meh2481/picopinball/code/displayController/images/score_display_vert.bmp

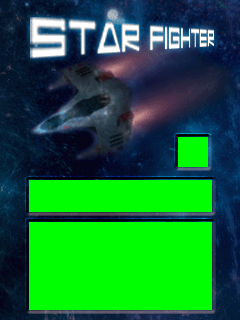
code/displayController/images/score_display_vert.bmp
