meh2481/picopinball/README.md

# picopinball
Physical Pi Pico-Powered Pinball table heavily inspired by Space Cadet
