meh2481/picopinball/FreeCad/popBumperAssembly.FCStd

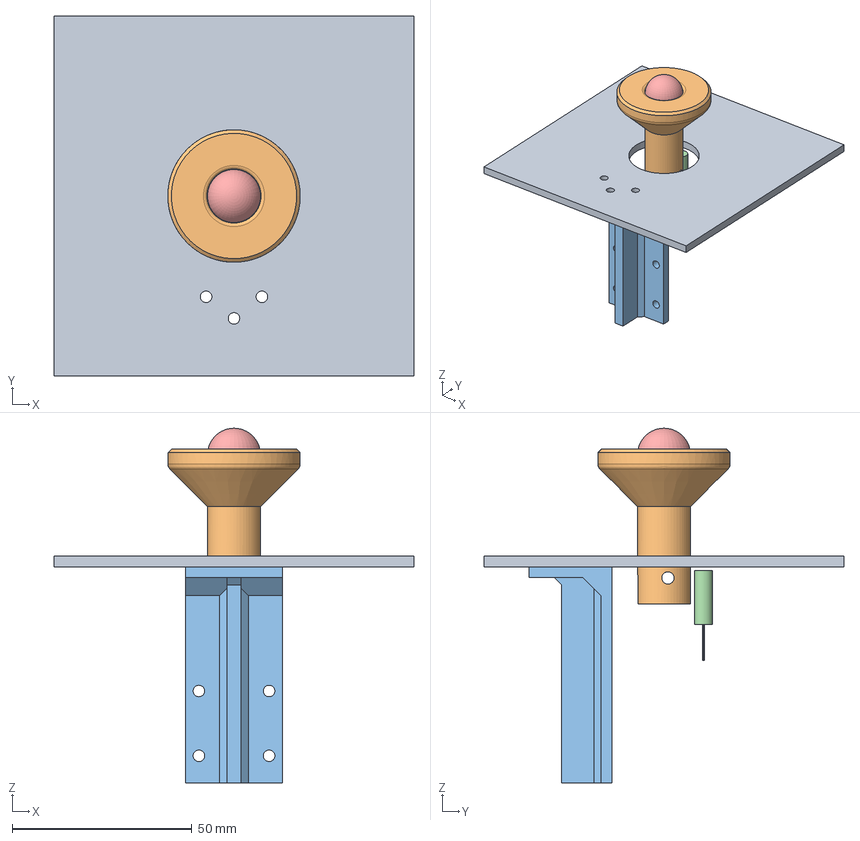
[picture p2: CAD file, 2022-09-14]
FreeCad/popBumperAssembly.FCStd
100.0 x 100.0 x 98.5 mm
board
bumperPlunger
popBumperSolenoidBracket
mockVibrationSensor
plungerCap
