meh2481/picopinball/FreeCad/measurements/slingshotCover.FCStd

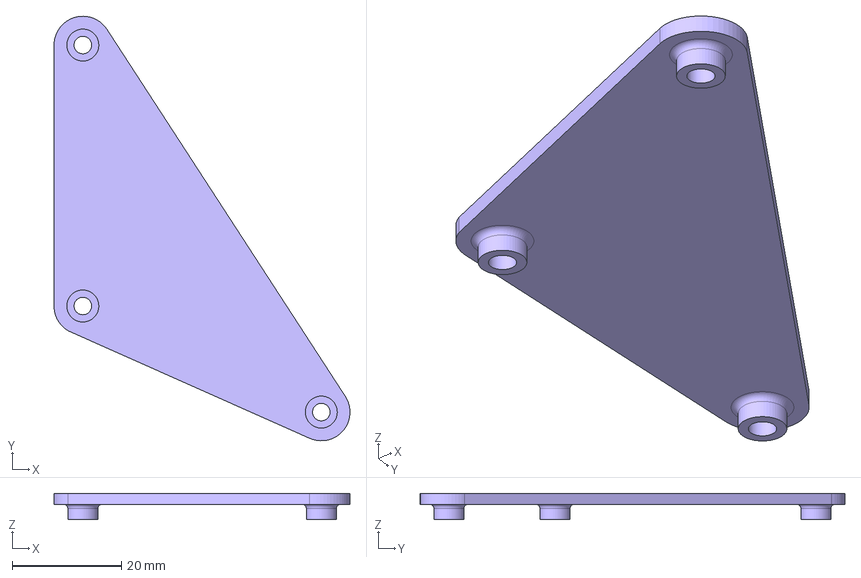
[picture p3: CAD file, 2022-11-23]
FreeCad/measurements/slingshotCover.FCStd
54.1 x 77.6 x 4.80 mm
