meh2481/picopinball/FreeCad/plungerGuide.FCStd

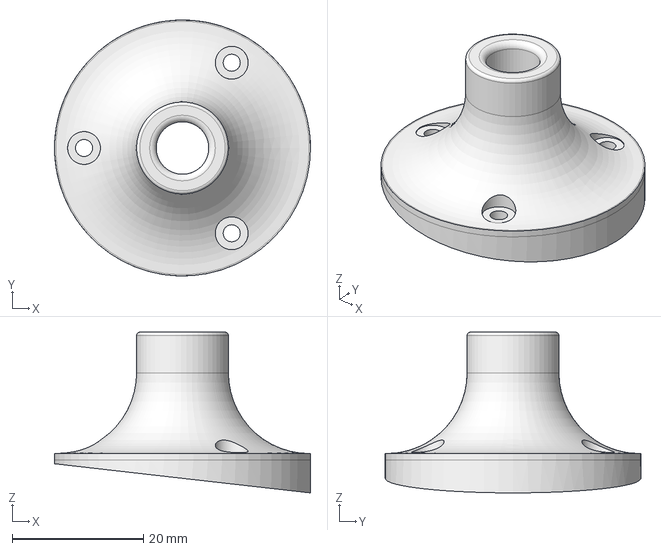
[picture p4: CAD file, 2022-12-01]
FreeCad/plungerGuide.FCStd
39.0 x 39.0 x 24.5 mm
