meh2481/picopinball/FreeCad/flipper2.FCStd

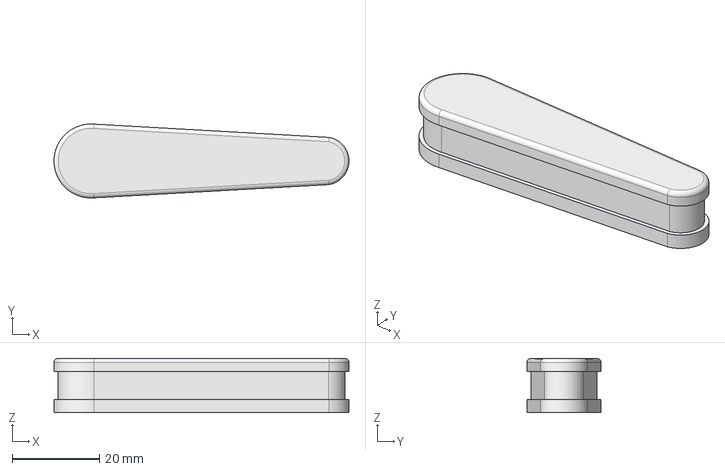
[picture p5: CAD file, 2022-11-29]
FreeCad/flipper2.FCStd
67.7 x 17.0 x 12.5 mm
