meh2481/picopinball/FreeCad/slingshot_switch4.FCStd

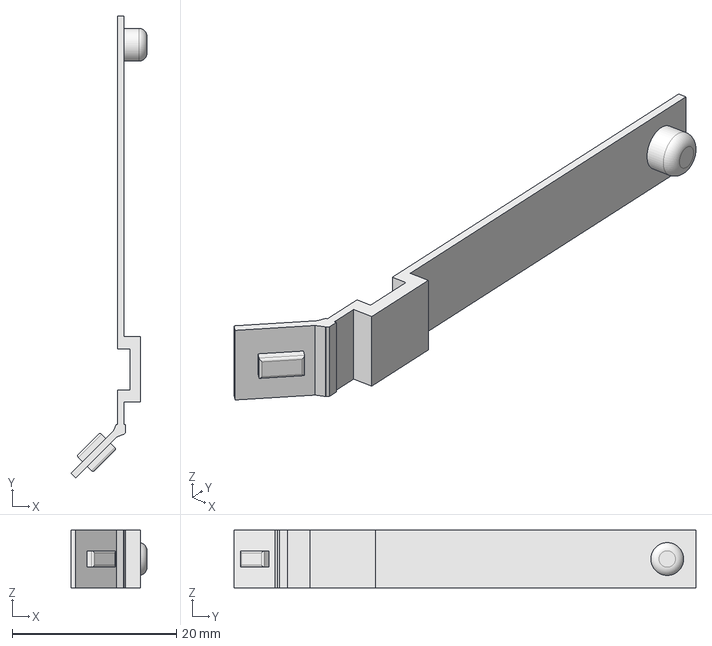
[picture p6: CAD file, 2022-11-26]
FreeCad/slingshot_switch4.FCStd
9.26 x 56.2 x 7.00 mm
