meh2481/picopinball/FreeCad/triangleLightHolder.FCStd

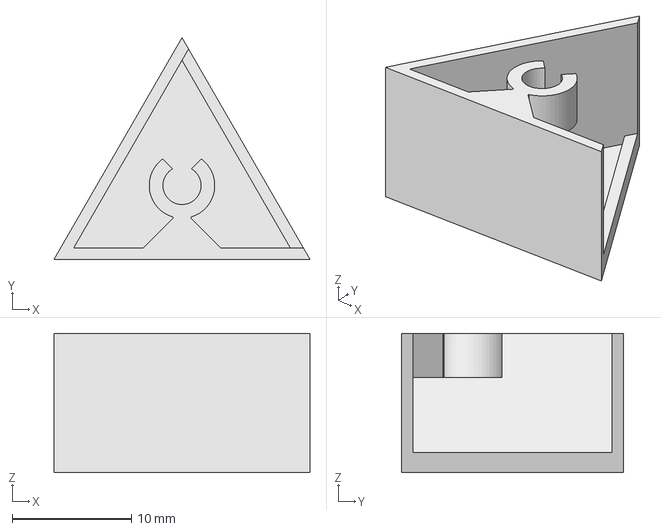
[picture p7: CAD file, 2022-11-23]
FreeCad/triangleLightHolder.FCStd
21.5 x 18.6 x 11.7 mm
