meh2481/picopinball/FreeCad/threeArrowsLightHolder.FCStd

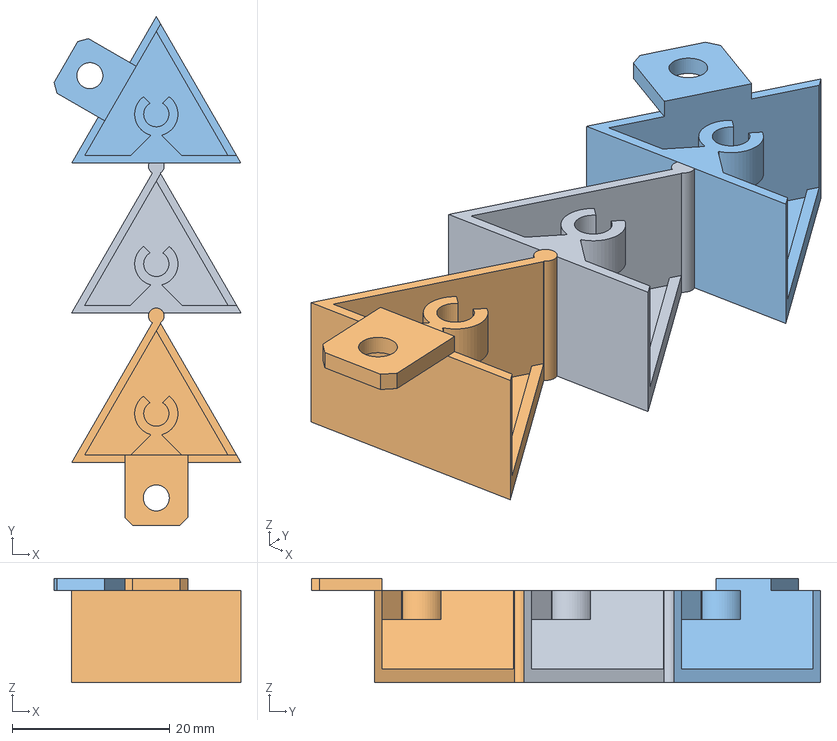
[picture p8: CAD file, 2022-11-23]
FreeCad/threeArrowsLightHolder.FCStd
23.7 x 64.6 x 13.2 mm
arrowMiddle
arrowBottom
arrowTop
