meh2481/picopinball/FreeCad/circleLightHolder.FCStd

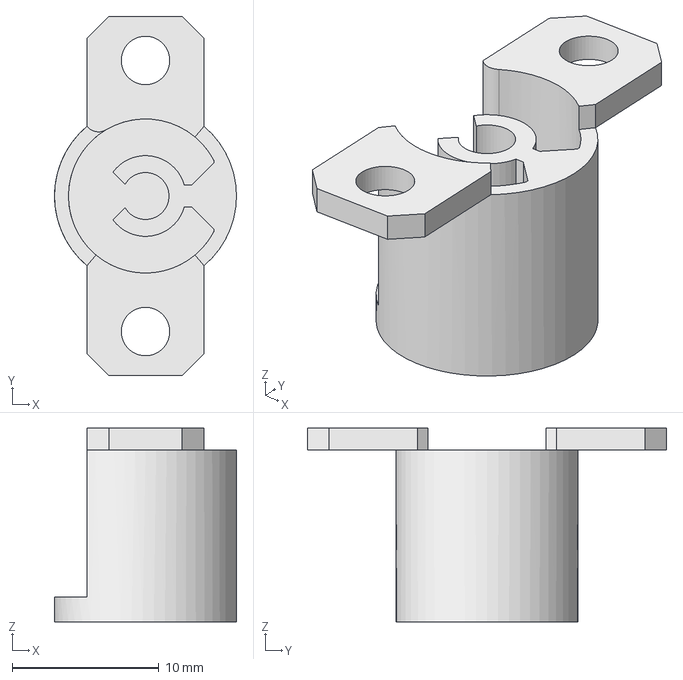
[picture p9: CAD file, 2022-11-23]
FreeCad/circleLightHolder.FCStd
12.4 x 24.5 x 13.2 mm
