meh2481/picopinball/FreeCad/hyperspaceBarLight-36.FCStd

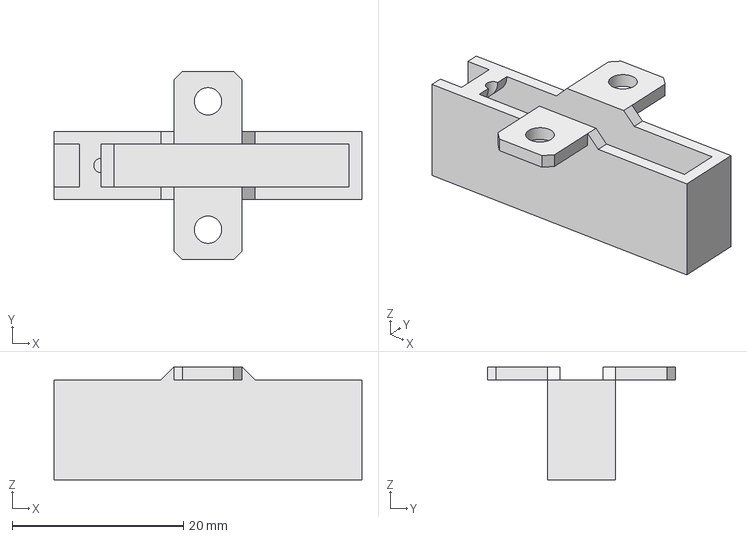
[picture p10: CAD file, 2022-11-23]
FreeCad/hyperspaceBarLight-36.FCStd
36.0 x 22.0 x 13.2 mm
