meh2481/picopinball/FreeCad/hyperspaceBarLight.FCStd

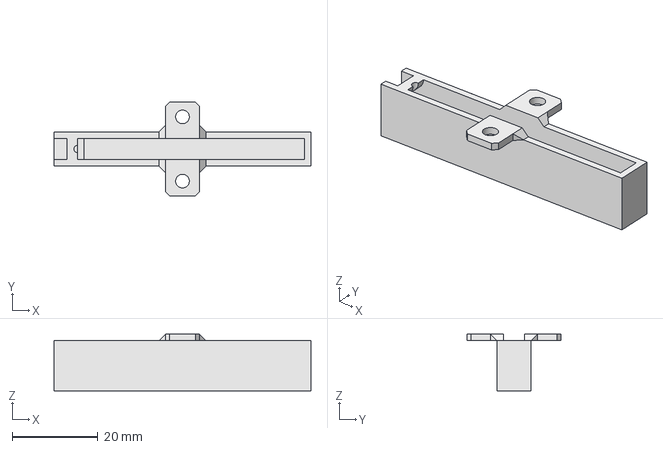
[picture p11: CAD file, 2022-11-23]
FreeCad/hyperspaceBarLight.FCStd
60.0 x 22.0 x 13.2 mm
