meh2481/picopinball/FreeCad/displayBracket.FCStd

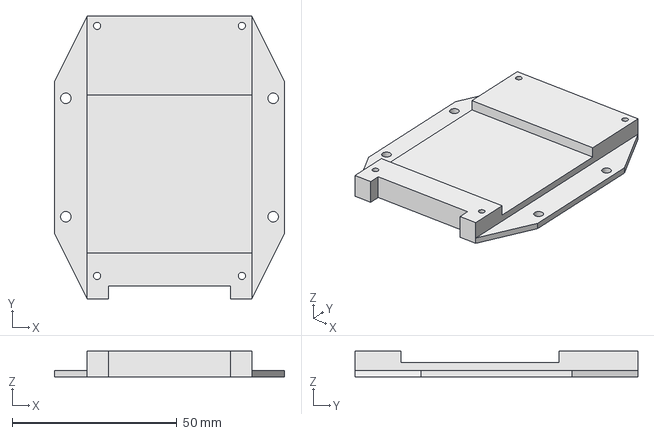
[picture p12: CAD file, 2022-11-17]
FreeCad/displayBracket.FCStd
70.0 x 86.0 x 7.80 mm
