meh2481/picopinball/FreeCad/ledRingHolder.FCStd

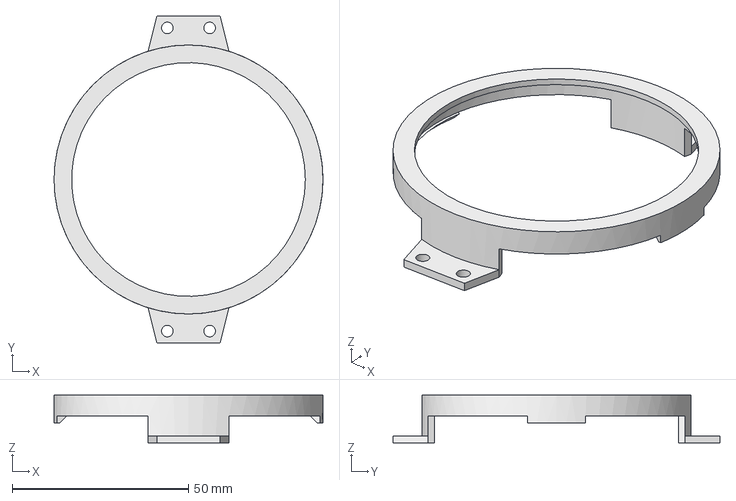
[picture p13: CAD file, 2022-11-17]
FreeCad/ledRingHolder.FCStd
76.3 x 92.8 x 13.6 mm
