meh2481/picopinball/FreeCad/cableClip_tiny.FCStd

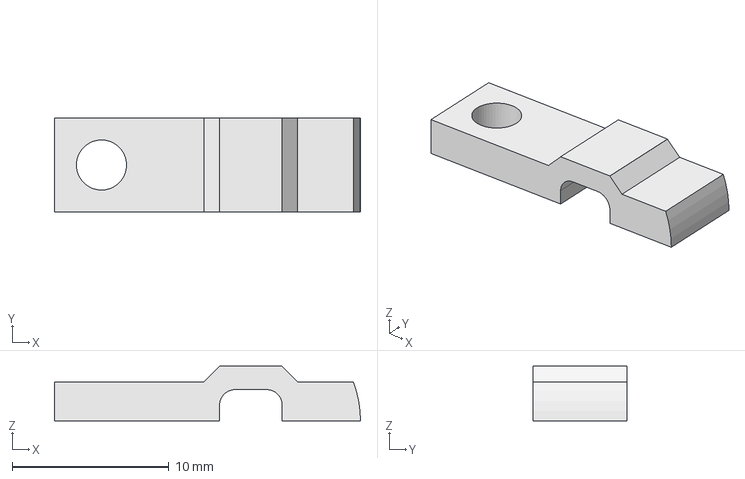
[picture p14: CAD file, 2022-11-09]
FreeCad/cableClip_tiny.FCStd
19.5 x 6.00 x 3.50 mm
