meh2481/picopinball/FreeCad/pegglePeg.FCStd

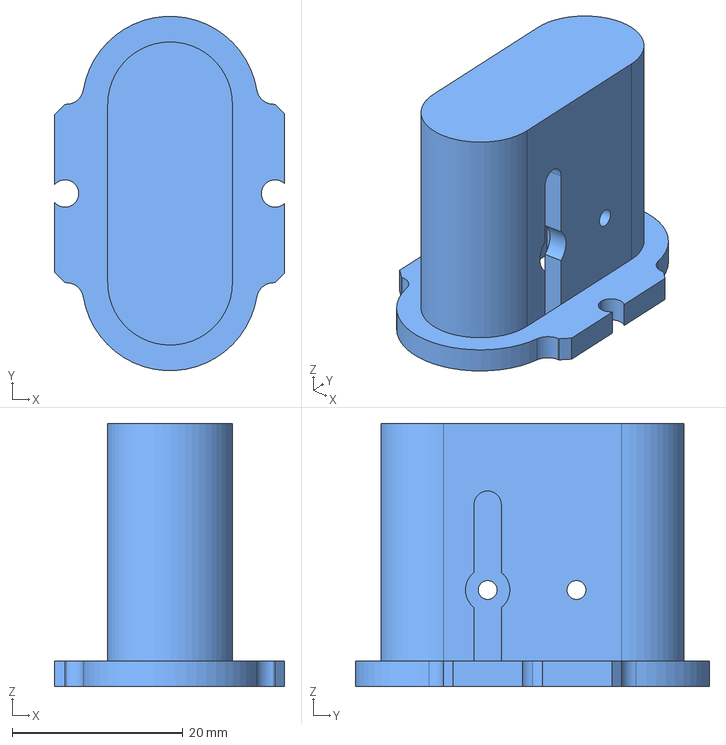
[picture p15: CAD file, 2022-10-25]
FreeCad/pegglePeg.FCStd
27.0 x 41.5 x 30.8 mm
