meh2481/picopinball/FreeCad/dowelSpringPlug.FCStd

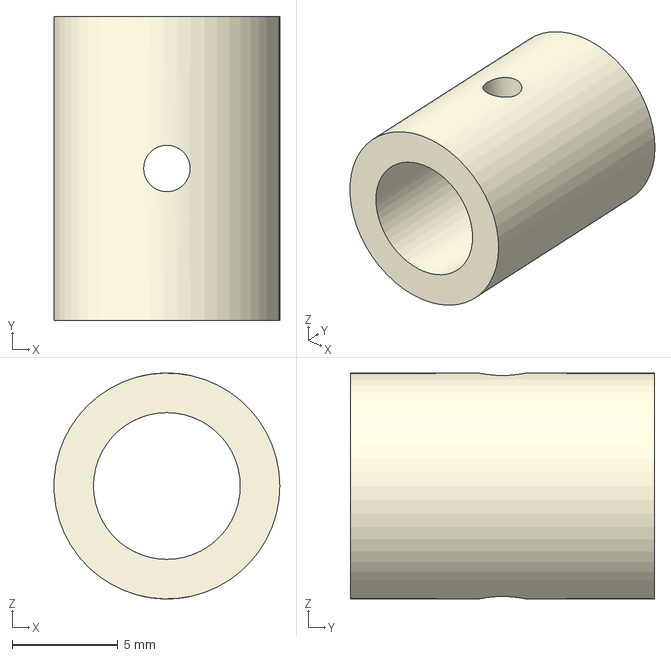
[picture p16: CAD file, 2022-10-25]
FreeCad/dowelSpringPlug.FCStd
10.7 x 14.4 x 10.7 mm
