meh2481/picopinball/FreeCad/slingshotCover.FCStd

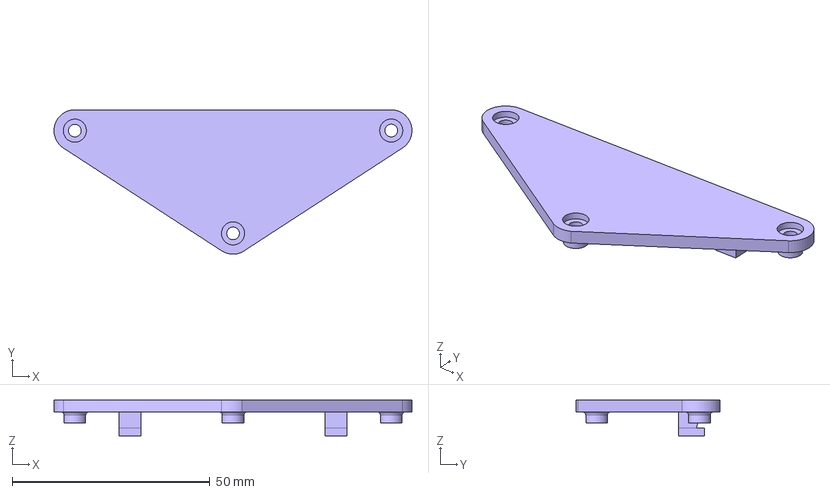
[picture p17: CAD file, 2022-10-22]
FreeCad/slingshotCover.FCStd
90.5 x 36.5 x 9.00 mm
