meh2481/picopinball/FreeCad/slingshot2.FCStd

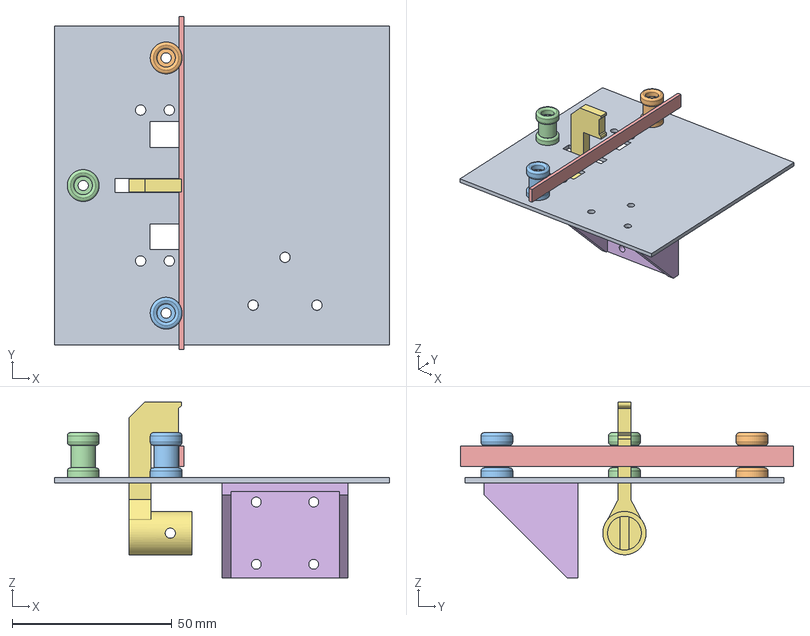
[picture p18: CAD file, 2022-10-22]
FreeCad/slingshot2.FCStd
105.0 x 104.4 x 55.0 mm
table
bumper
bumper001
bumper002
mockBand
solenoidBracket
kickerBracket
