meh2481/picopinball/FreeCad/cableClip-taller.FCStd

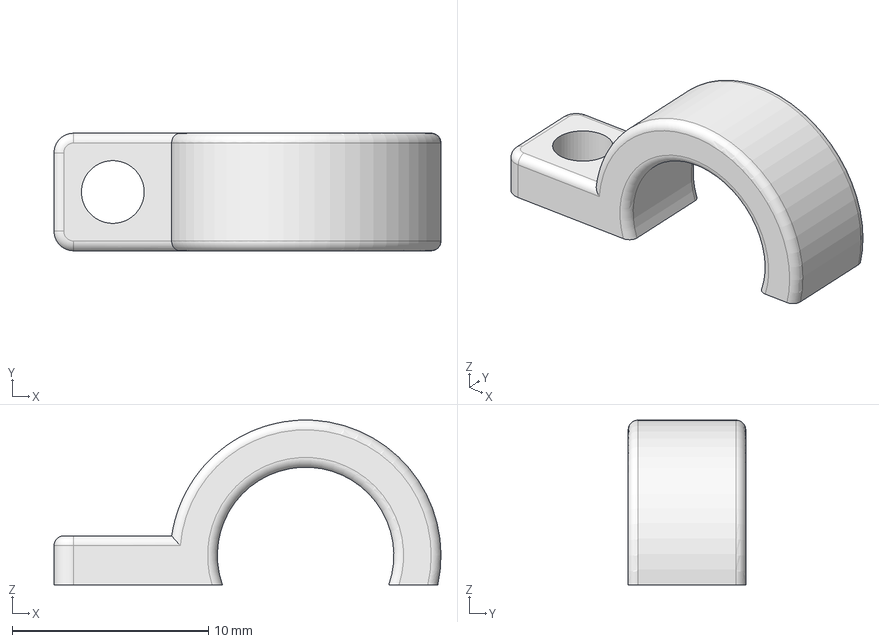
[picture p19: CAD file, 2022-10-22]
FreeCad/cableClip-taller.FCStd
19.7 x 6.00 x 8.40 mm
