meh2481/picopinball/FreeCad/boxMeasurements.FCStd

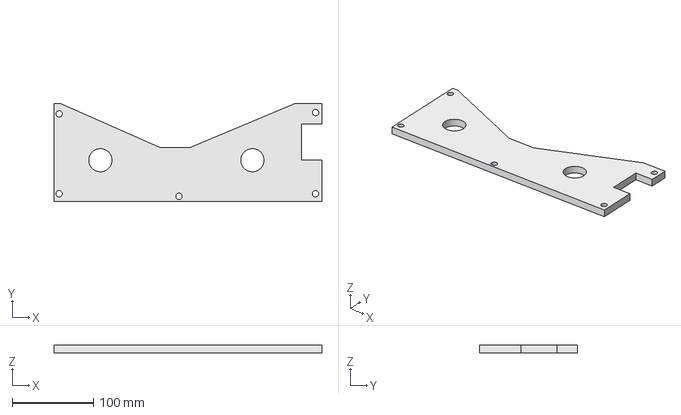
[picture p20: CAD file, 2022-10-10]
FreeCad/boxMeasurements.FCStd
330.2 x 120.7 x 9.53 mm
