meh2481/picopinball/FreeCad/cornerPlexiglassBracket.FCStd

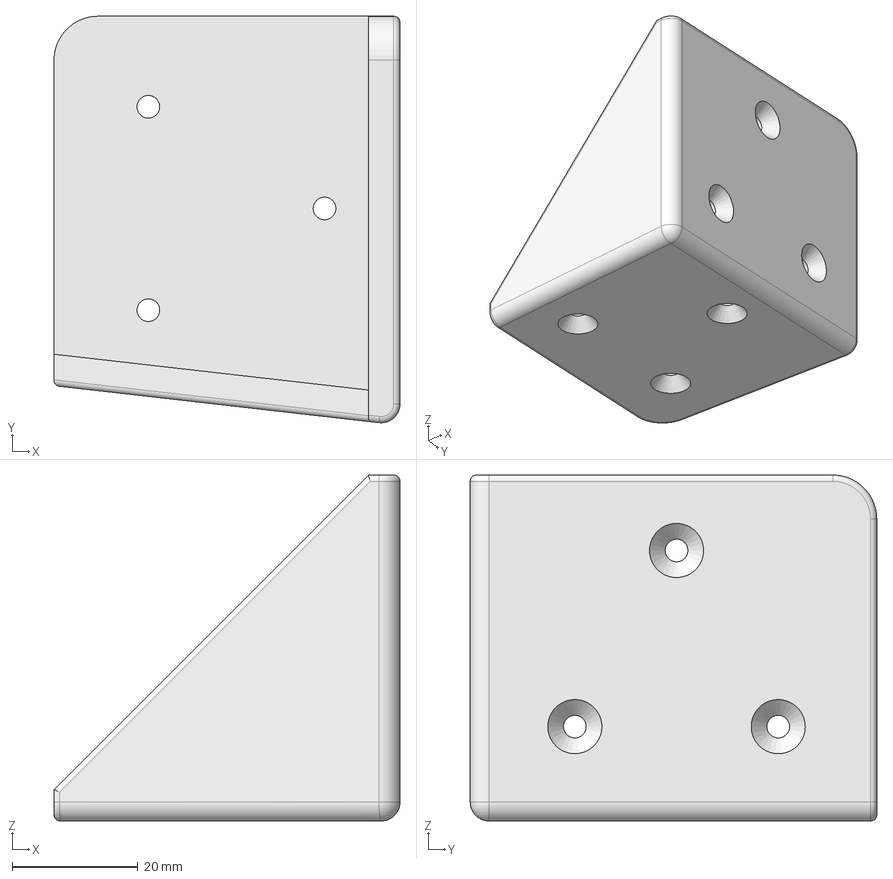
[picture p21: CAD file, 2022-10-10]
FreeCad/cornerPlexiglassBracket.FCStd
55.0 x 64.6 x 55.0 mm
