meh2481/picopinball/FreeCad/ledStripTrack_noCorners_extended.FCStd

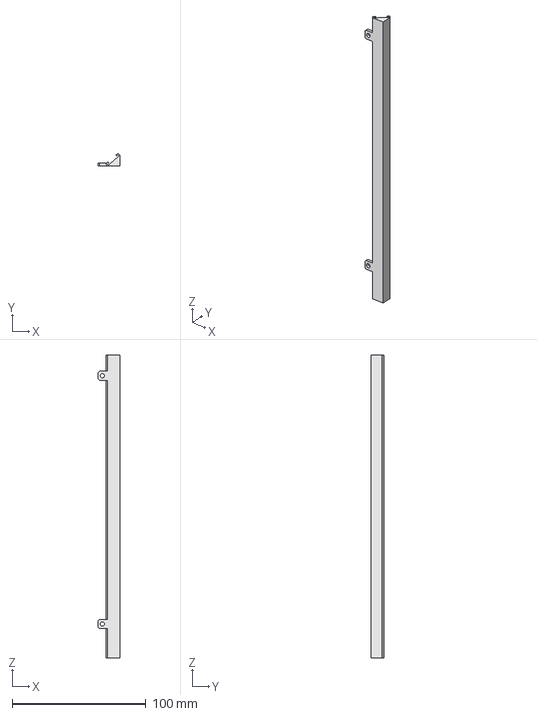
[picture p22: CAD file, 2022-10-10]
FreeCad/ledStripTrack_noCorners_extended.FCStd
16.2 x 9.51 x 226.4 mm
