meh2481/picopinball/FreeCad/ledStripTrack.FCStd

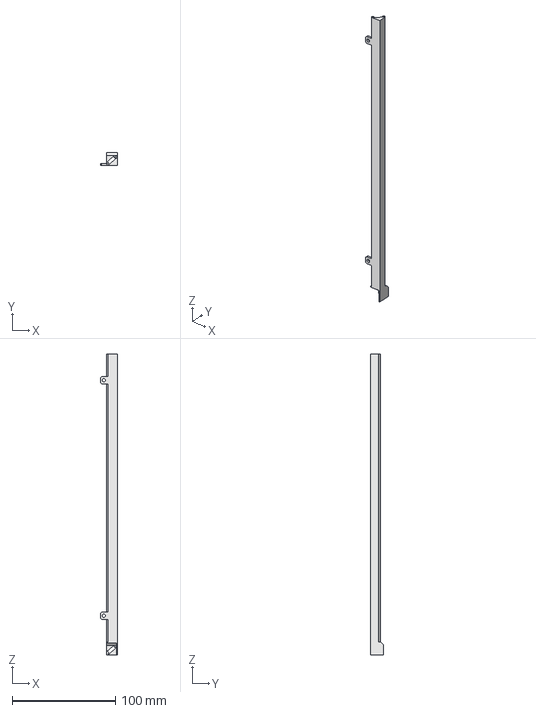
[picture p23: CAD file, 2022-10-09]
FreeCad/ledStripTrack.FCStd
16.2 x 12.7 x 292.1 mm
