meh2481/picopinball/FreeCad/ledStripTrack_noCorners.FCStd

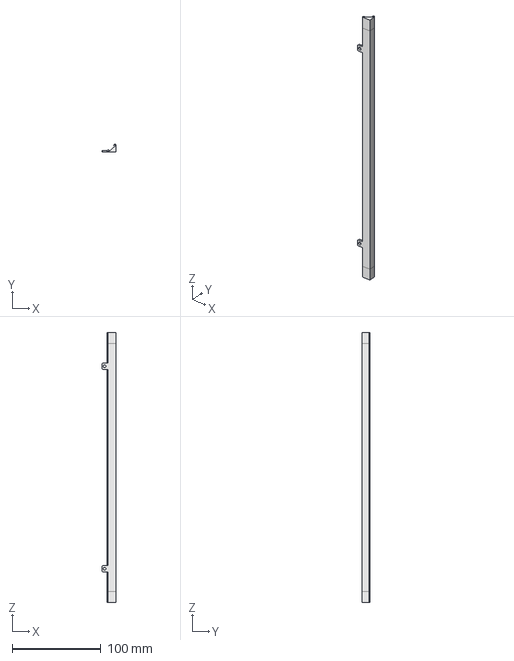
[picture p24: CAD file, 2022-10-09]
FreeCad/ledStripTrack_noCorners.FCStd
16.2 x 9.51 x 304.8 mm
