meh2481/picopinball/FreeCad/spaceship_post_cover.FCStd

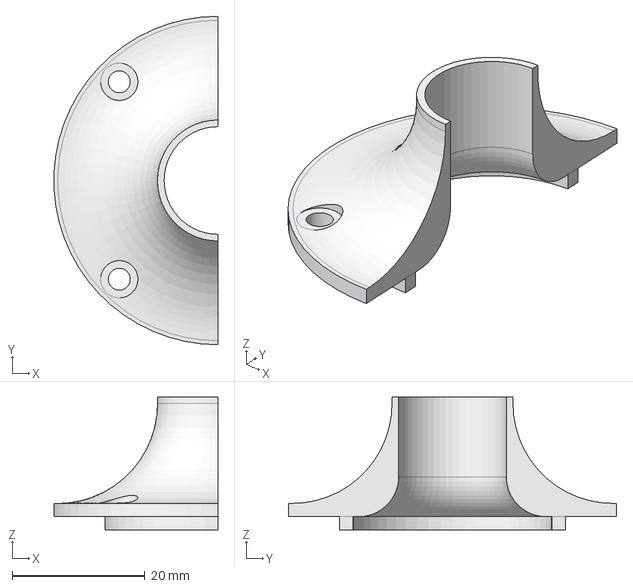
[picture p25: CAD file, 2022-10-09]
FreeCad/spaceship_post_cover.FCStd
24.7 x 49.4 x 20.0 mm
