meh2481/picopinball/FreeCad/plexiglassGuide.FCStd

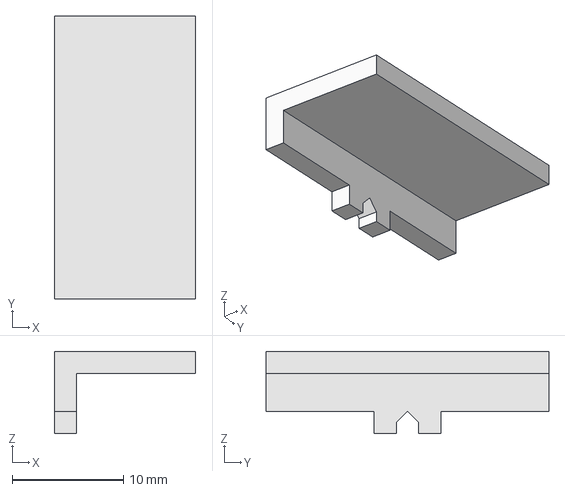
[picture p26: CAD file, 2022-10-09]
FreeCad/plexiglassGuide.FCStd
12.7 x 25.4 x 7.40 mm
