meh2481/picopinball/FreeCad/spaceship_postHolder_part2.FCStd

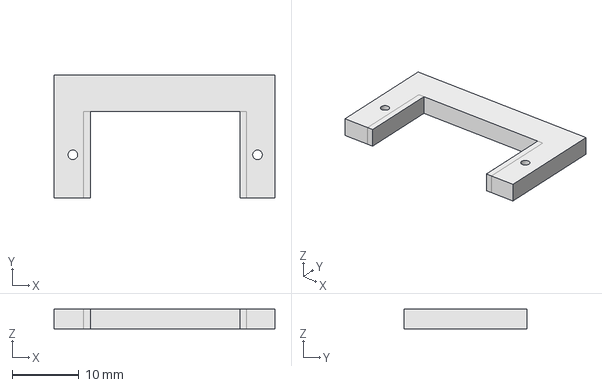
[picture p27: CAD file, 2022-10-09]
FreeCad/spaceship_postHolder_part2.FCStd
33.2 x 18.5 x 3.00 mm
