meh2481/picopinball/FreeCad/speakerHoleJig.FCStd

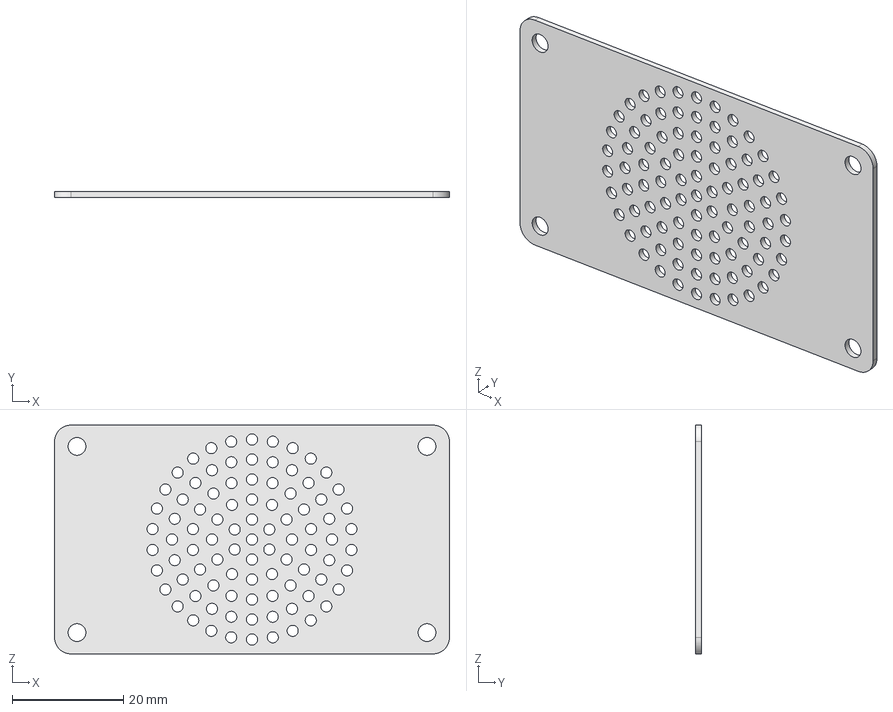
[picture p28: CAD file, 2022-09-30]
FreeCad/speakerHoleJig.FCStd
71.1 x 1.00 x 41.2 mm
