meh2481/picopinball/FreeCad/cableClip.FCStd

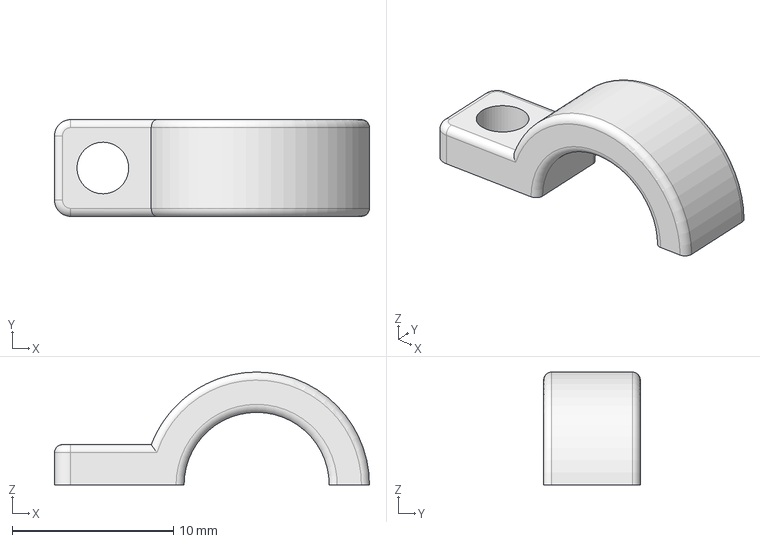
[picture p29: CAD file, 2022-09-30]
FreeCad/cableClip.FCStd
19.5 x 6.00 x 7.00 mm
