meh2481/picopinball/FreeCad/amplifierBracket.FCStd

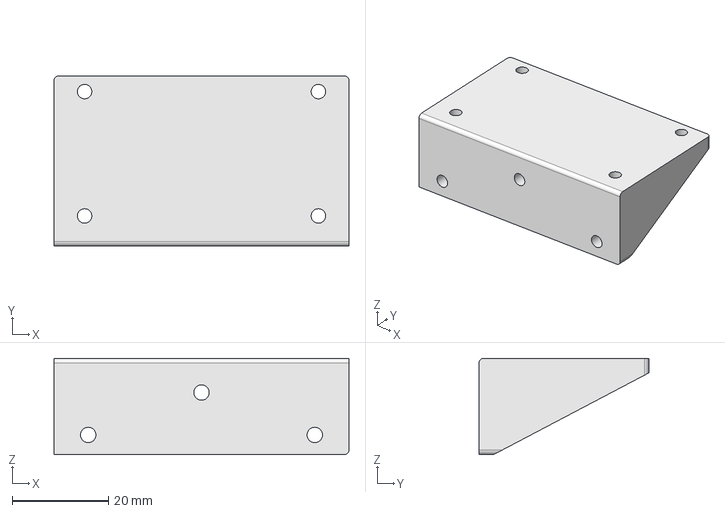
[picture p30: CAD file, 2022-09-30]
FreeCad/amplifierBracket.FCStd
61.2 x 35.3 x 20.0 mm
