meh2481/picopinball/FreeCad/switchBracket2.FCStd

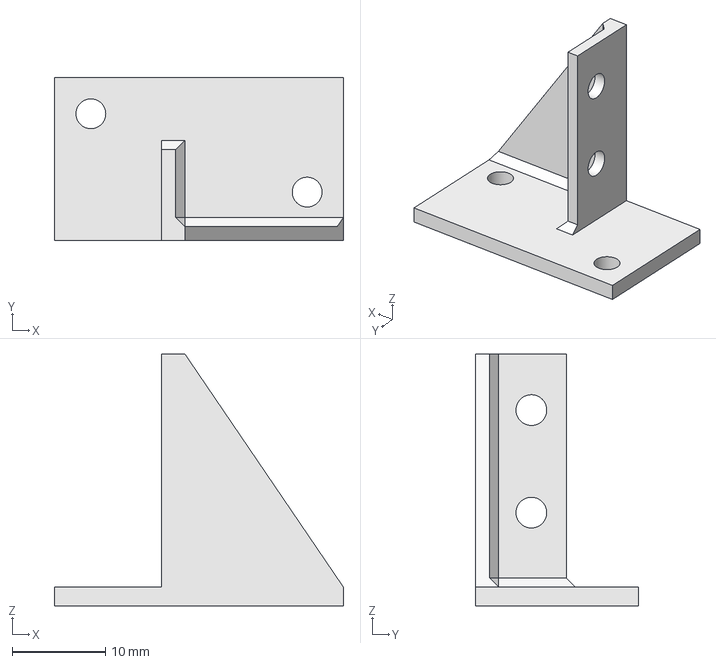
[picture p31: CAD file, 2022-09-25]
FreeCad/switchBracket2.FCStd
31.0 x 17.5 x 27.0 mm
