meh2481/picopinball/FreeCad/popBumperTestBoard2.FCStd

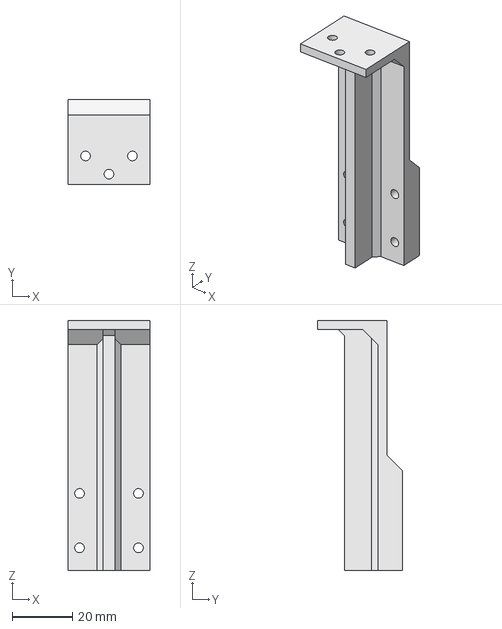
[picture p32: CAD file, 2022-09-25]
FreeCad/popBumperTestBoard2.FCStd
27.0 x 28.2 x 82.7 mm
