meh2481/picopinball/FreeCad/switchHolder.FCStd

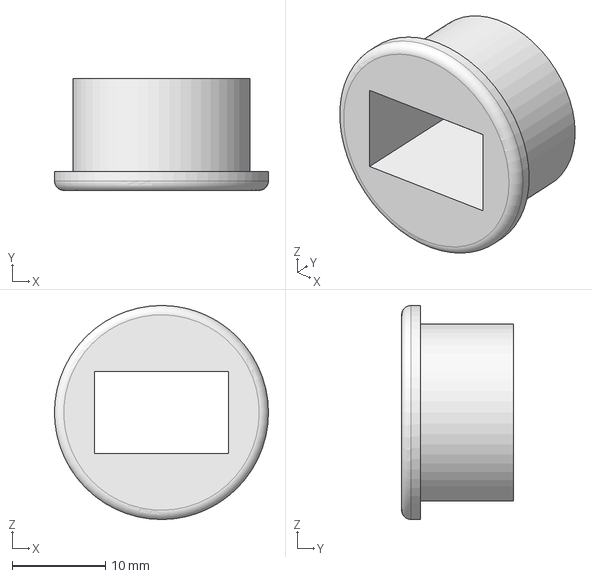
[picture p33: CAD file, 2022-09-25]
FreeCad/switchHolder.FCStd
23.0 x 12.0 x 23.0 mm
