meh2481/picopinball/FreeCad/dropTarget.FCStd

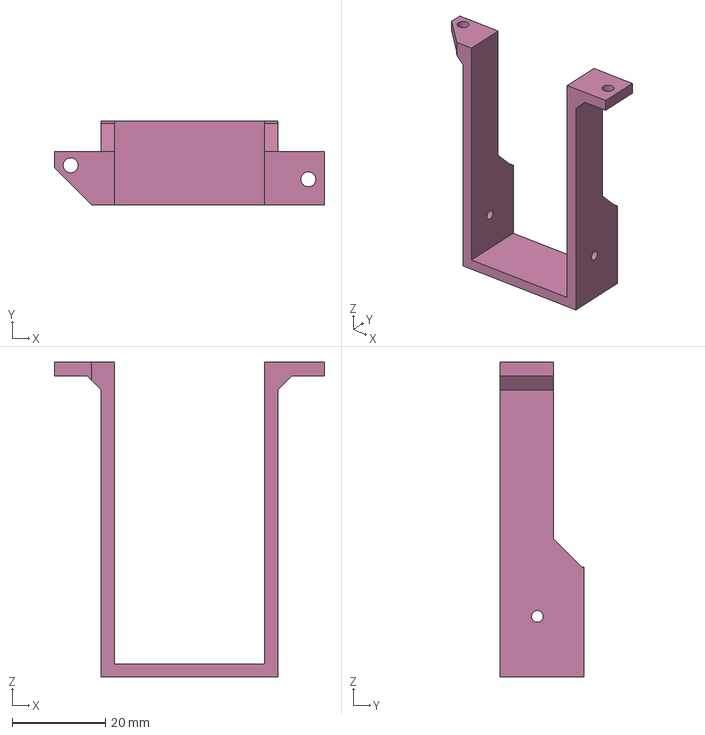
[picture p34: CAD file, 2022-09-14]
FreeCad/dropTarget.FCStd
58.0 x 18.0 x 67.6 mm
