meh2481/picopinball/FreeCad/flipperBearingHolder.FCStd

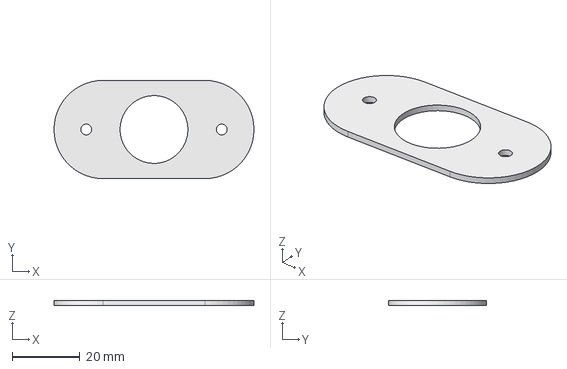
[picture p35: CAD file, 2022-08-31]
FreeCad/flipperBearingHolder.FCStd
59.0 x 29.0 x 1.50 mm
