meh2481/picopinball/FreeCad/flipper_underside5.FCStd

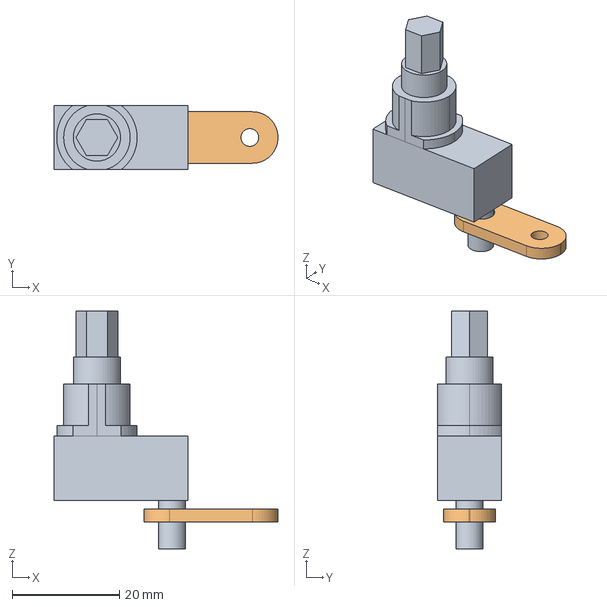
[picture p36: CAD file, 2022-08-31]
FreeCad/flipper_underside5.FCStd
41.8 x 12.0 x 44.3 mm
flipper_underside
solenoid_lever
