meh2481/picopinball/FreeCad/slingshot_switch5.FCStd

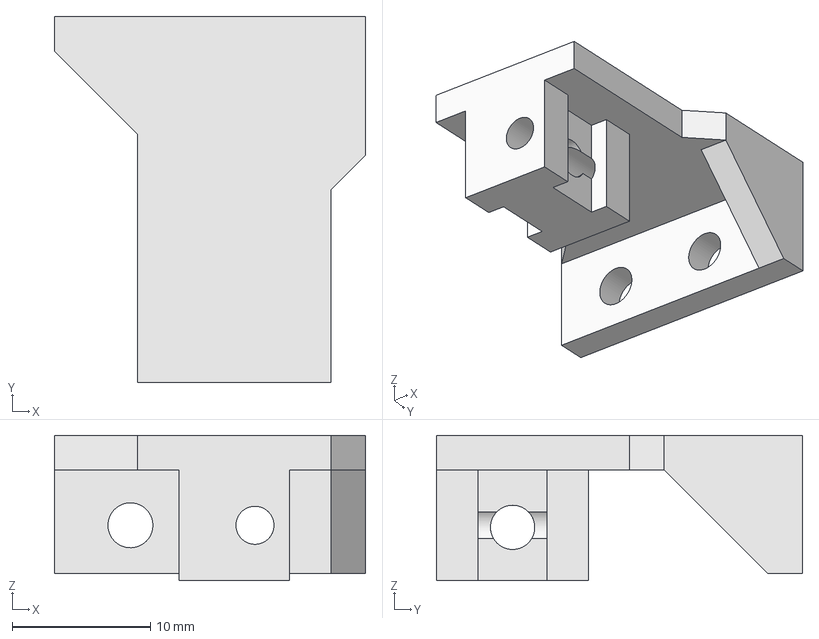
[picture p37: CAD file, 2022-08-31]
FreeCad/slingshot_switch5.FCStd
22.5 x 26.4 x 10.5 mm
