meh2481/picopinball/FreeCad/solenoidMockup.FCStd

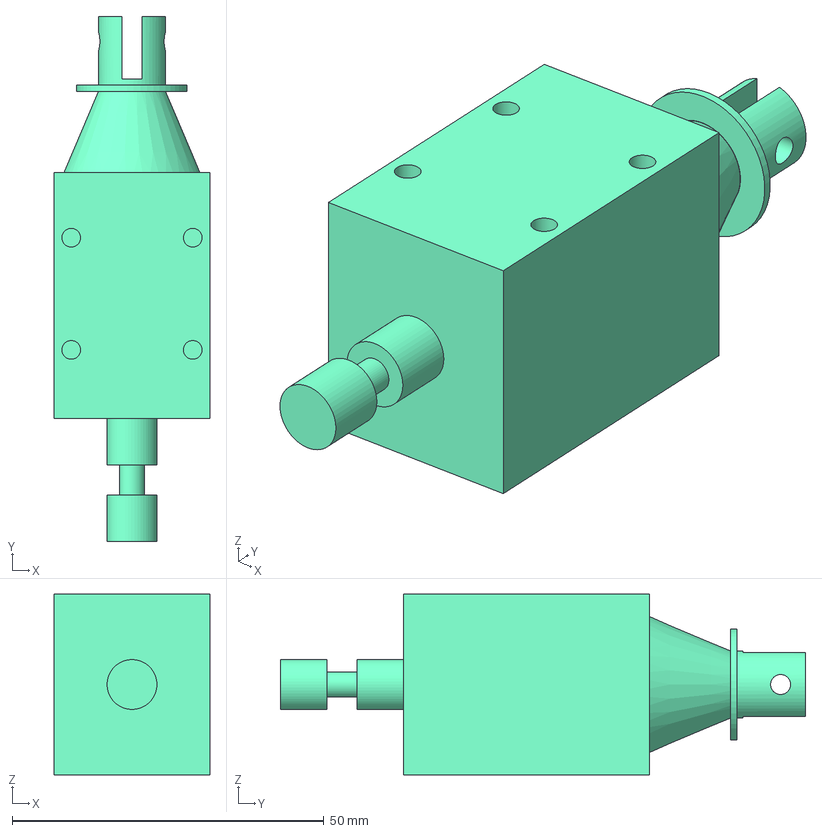
[picture p38: CAD file, 2022-05-30]
FreeCad/solenoidMockup.FCStd
25.0 x 84.2 x 29.0 mm
