meh2481/picopinball/FreeCad/pinballBumperSm.FCStd

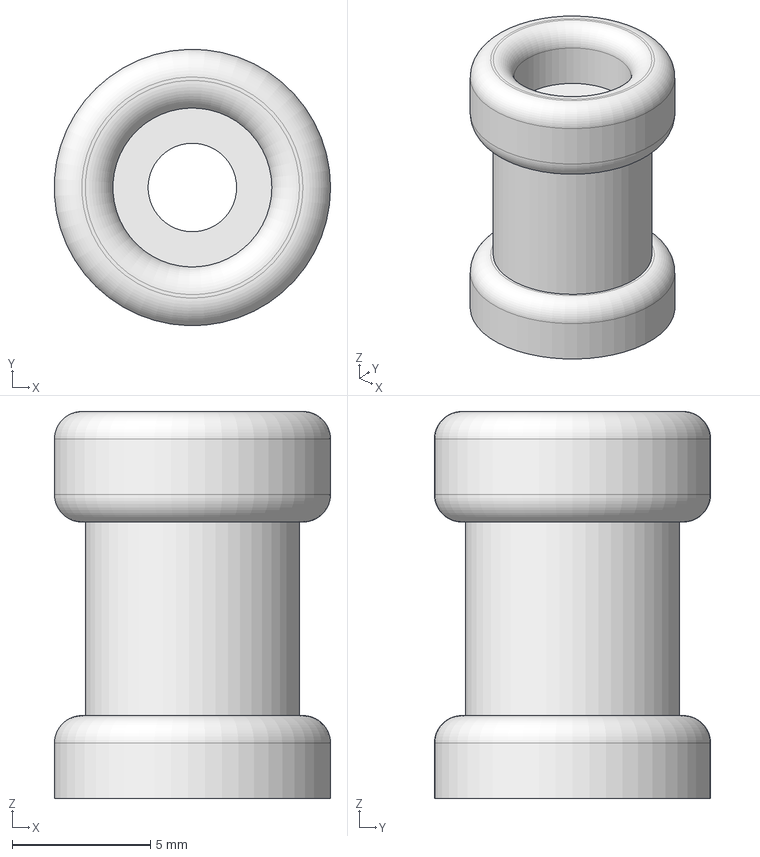
[picture p39: CAD file, 2022-05-24]
FreeCad/pinballBumperSm.FCStd
9.99 x 10.00 x 14.0 mm
