meh2481/picopinball/FreeCad/dropTarget_Target.FCStd

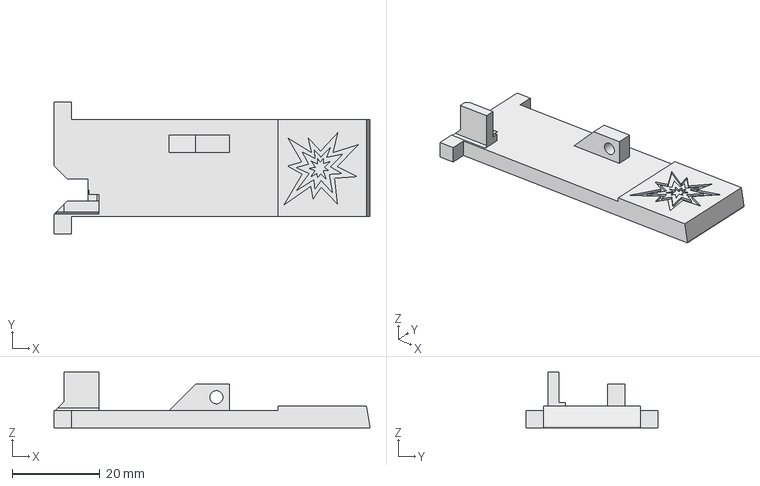
[picture p40: CAD file, 2022-05-24]
FreeCad/dropTarget_Target.FCStd
72.0 x 30.0 x 12.8 mm
