meh2481/picopinball/FreeCad/boardLayout.FCStd

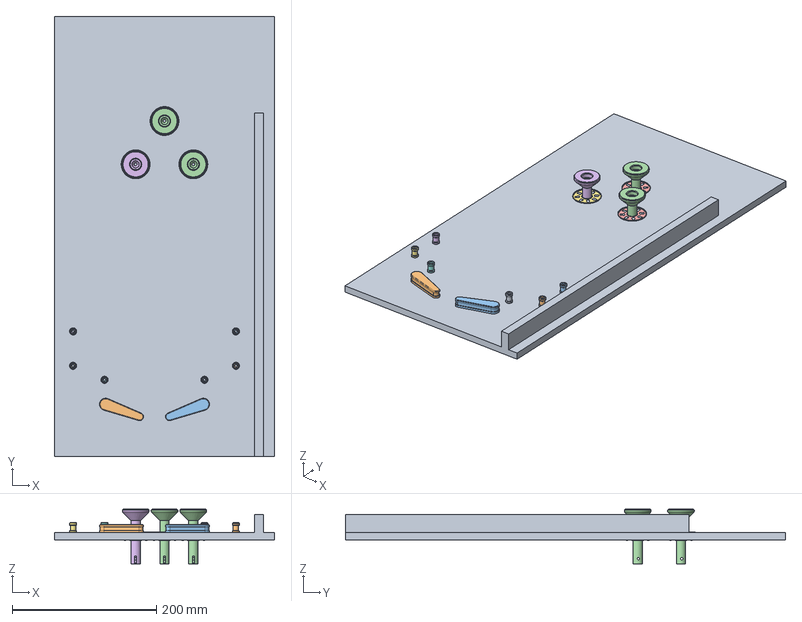
[picture p41: CAD file, 2022-05-19]
FreeCad/boardLayout.FCStd
304.8 x 609.6 x 76.0 mm
base
Flipper1
Flipper2
bumperPlunger
popBumperSensor
bumper
bumper002
bumper001
bumper003
bumper004
bumper005
bumperPlunger001
popBumperSensor001
bumperPlunger002
popBumperSensor002
