meh2481/picopinball/FreeCad/button.FCStd

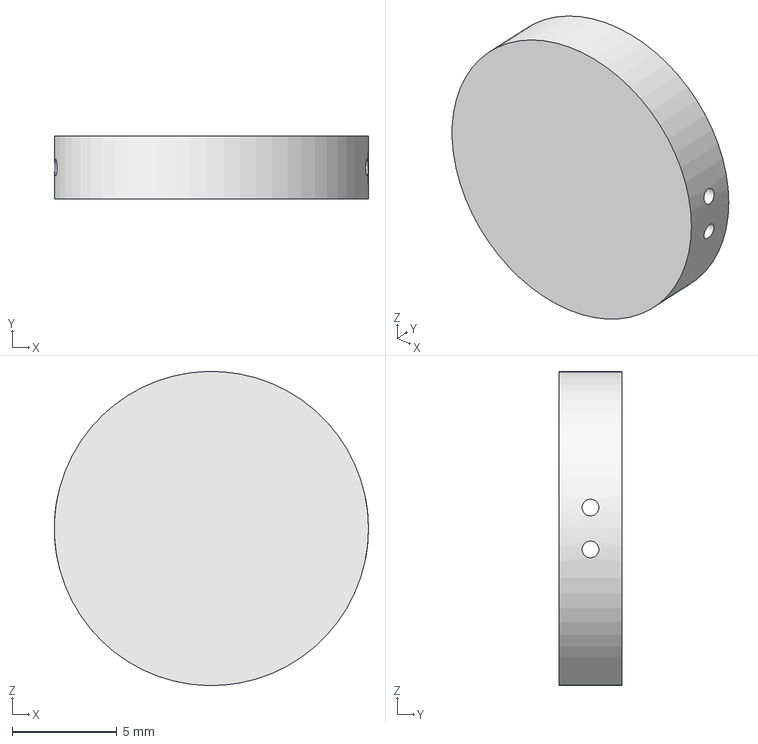
[picture p42: CAD file, 2022-05-08]
FreeCad/button.FCStd
15.0 x 3.00 x 15.0 mm
