meh2481/picopinball/FreeCad/buttonSwitch_bracket.FCStd

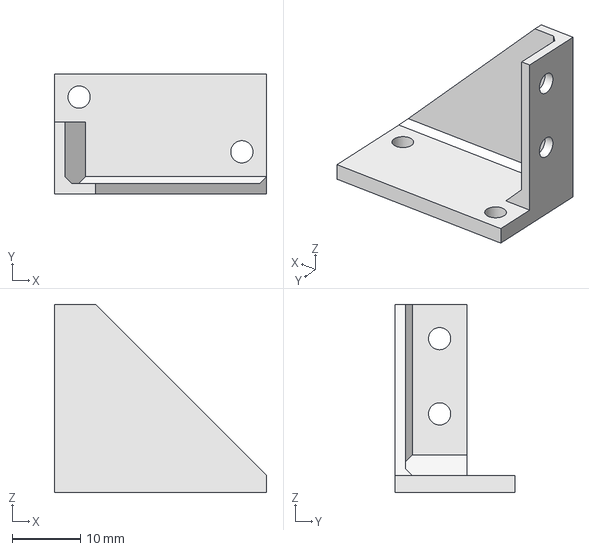
[picture p43: CAD file, 2022-05-08]
FreeCad/buttonSwitch_bracket.FCStd
31.0 x 17.5 x 27.5 mm
