meh2481/picopinball/FreeCad/testboard.FCStd

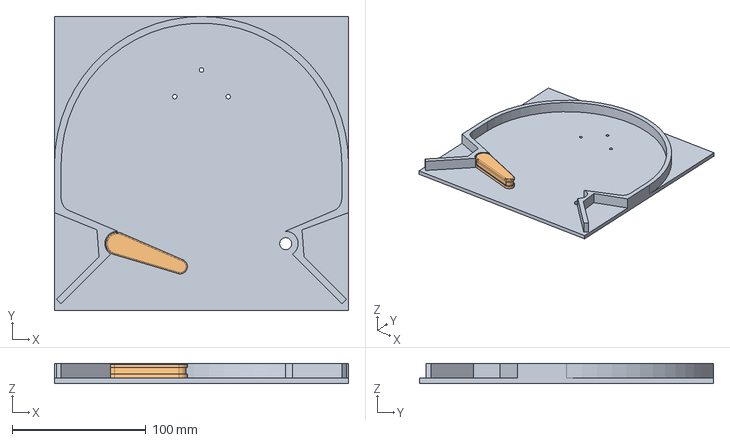
[picture p44: CAD file, 2022-04-18]
FreeCad/testboard.FCStd
220.0 x 220.0 x 15.1 mm
FlipperL
