meh2481/picopinball/FreeCad/hallSensorTester2.FCStd

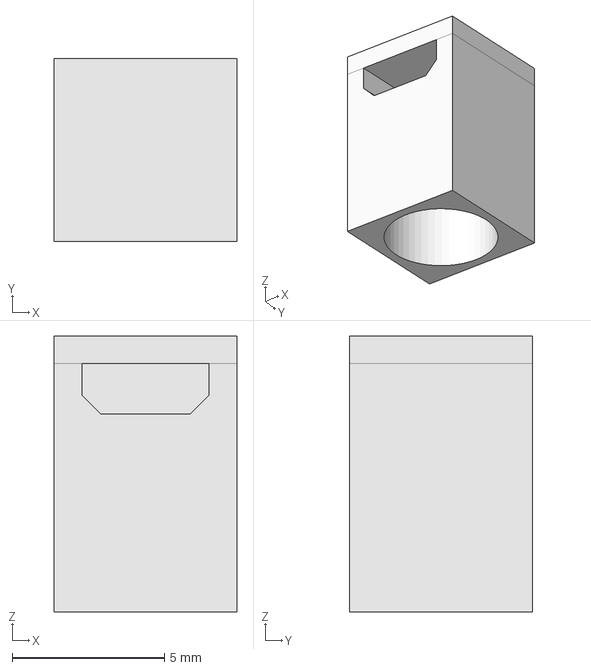
[picture p45: CAD file, 2022-04-18]
FreeCad/hallSensorTester2.FCStd
6.00 x 6.00 x 9.05 mm
