meh2481/picopinball/FreeCad/popBumperSolenoidBracket.FCStd

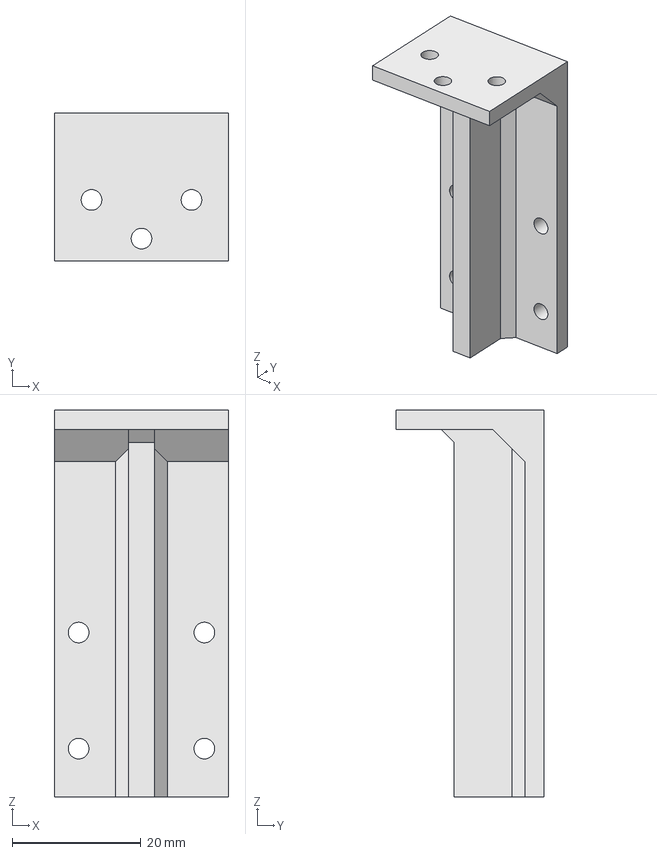
[picture p46: CAD file, 2022-04-18]
FreeCad/popBumperSolenoidBracket.FCStd
27.0 x 23.0 x 60.0 mm
