meh2481/picopinball/FreeCad/topCurveL.FCStd

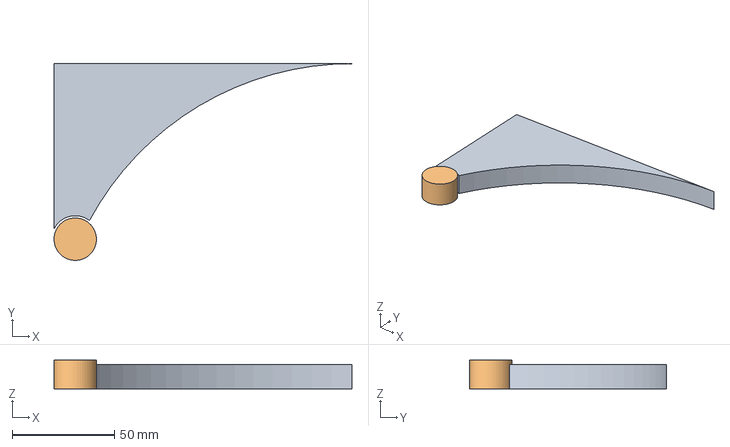
[picture p47: CAD file, 2022-04-18]
FreeCad/topCurveL.FCStd
146.1 x 96.4 x 14.0 mm
topCurveL
mockPeg
