meh2481/picopinball/FreeCad/popBumperPlunger.FCStd

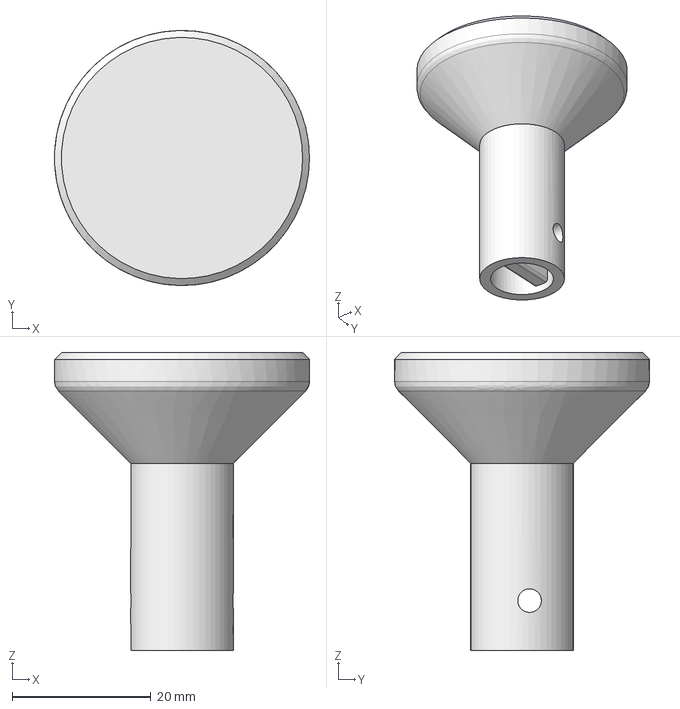
[picture p48: CAD file, 2022-04-18]
FreeCad/popBumperPlunger.FCStd
36.8 x 36.8 x 43.0 mm
