meh2481/picopinball/FreeCad/testboard3.FCStd

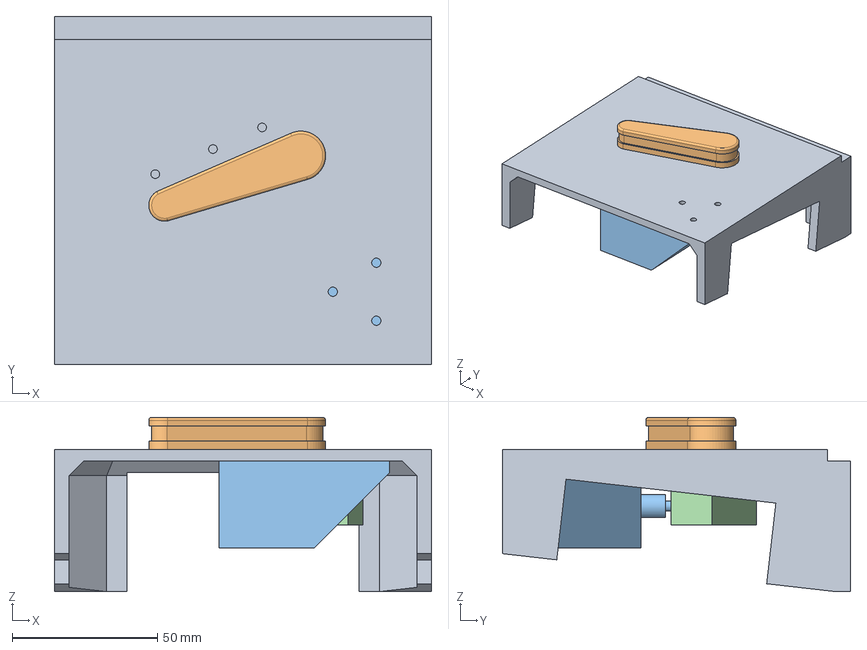
[picture p49: CAD file, 2022-04-18]
FreeCad/testboard3.FCStd
130.0 x 120.0 x 60.1 mm
Flipper
solenoidMockup
flipper_underside
