meh2481/picopinball/FreeCad/switchBracket.FCStd

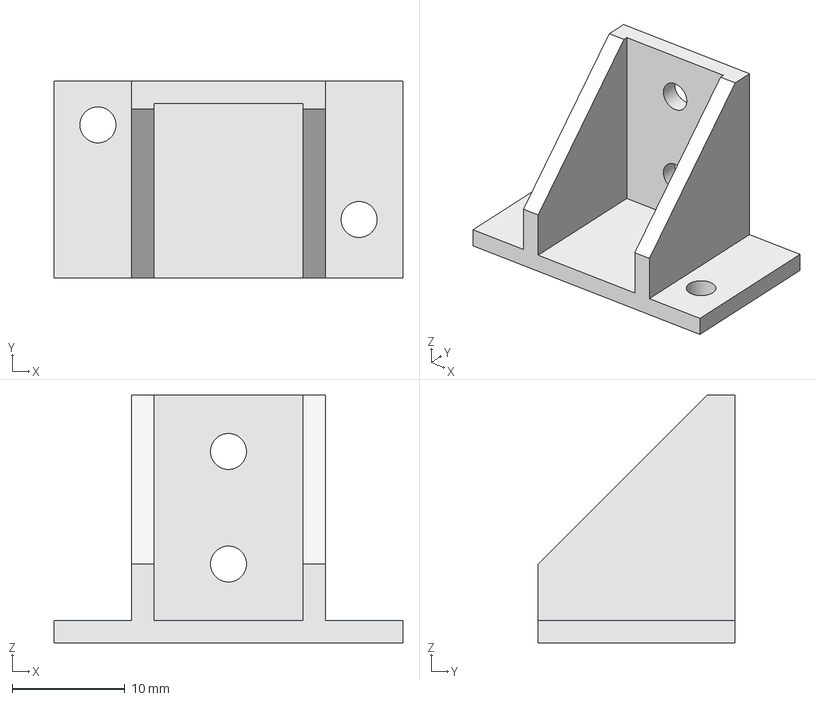
[picture p50: CAD file, 2022-04-18]
FreeCad/switchBracket.FCStd
31.0 x 17.5 x 22.0 mm
