meh2481/picopinball/FreeCad/topCurveR.FCStd

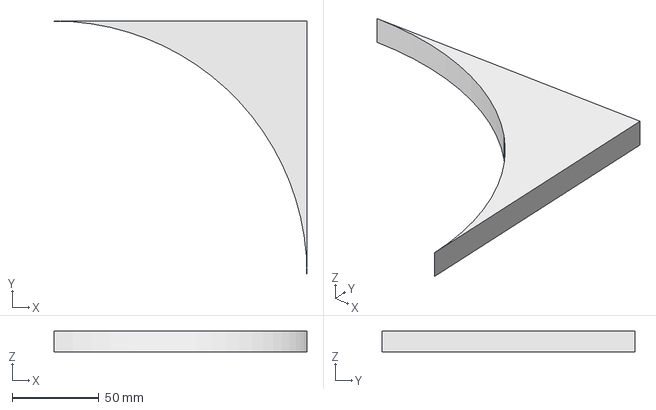
[picture p51: CAD file, 2022-04-18]
FreeCad/topCurveR.FCStd
146.1 x 146.1 x 12.0 mm
