meh2481/picopinball/FreeCad/spaceship_post.FCStd

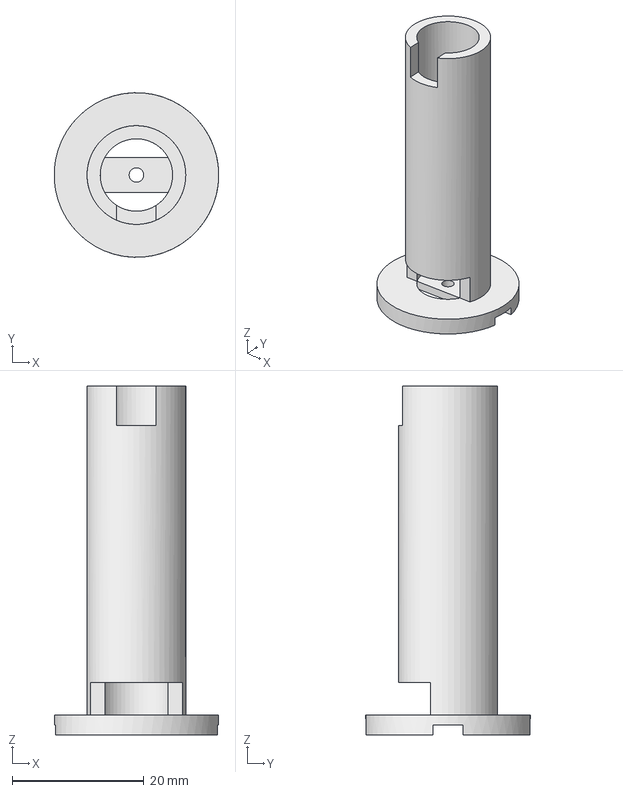
[picture p52: CAD file, 2022-04-18]
FreeCad/spaceship_post.FCStd
25.0 x 25.0 x 53.0 mm
