meh2481/picopinball/FreeCad/popBumperTestBoard.FCStd

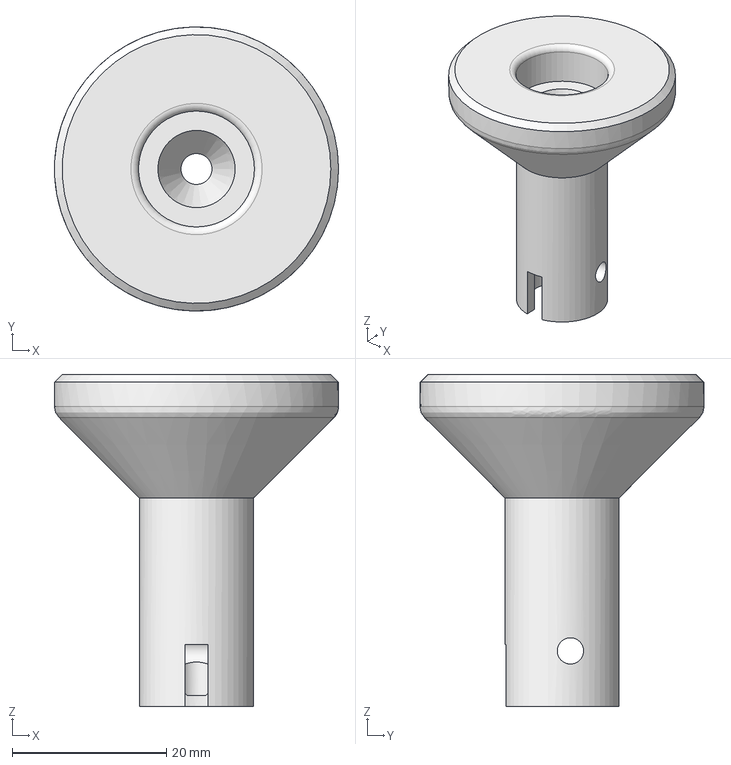
[picture p53: CAD file, 2022-04-18]
FreeCad/popBumperTestBoard.FCStd
36.8 x 36.8 x 43.0 mm
