meh2481/picopinball/FreeCad/pinballTable.FCStd

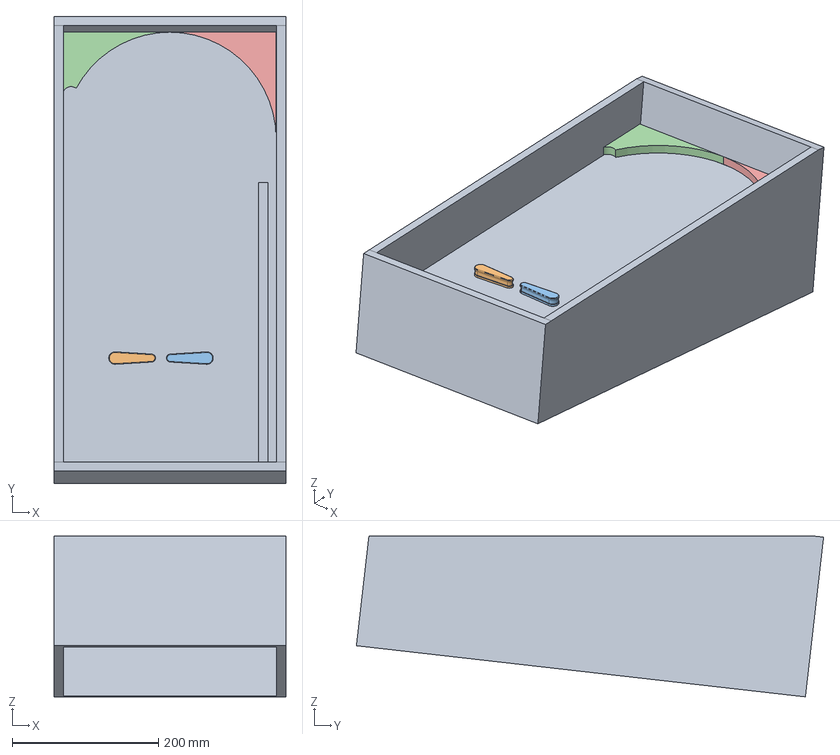
[picture p54: CAD file, 2022-04-18]
FreeCad/pinballTable.FCStd
317.5 x 639.4 x 220.0 mm
Table
FlipperL
FlipperR
topCurveL
topCurveR
