meh2481/picopinball/FreeCad/spaceship_laser2.FCStd

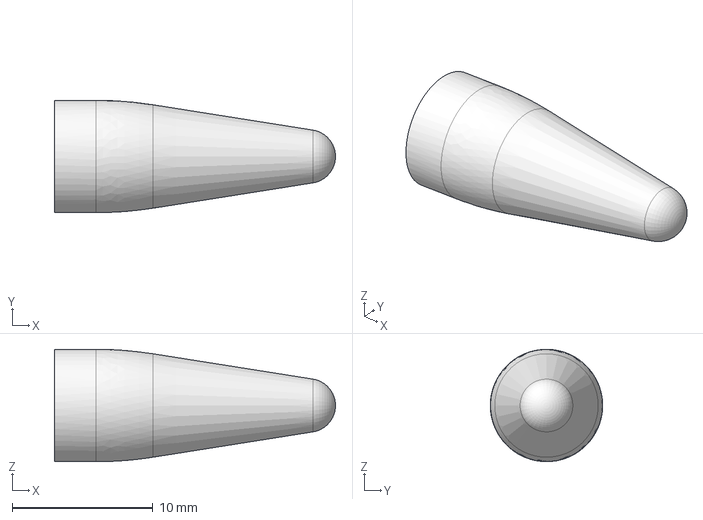
[picture p55: CAD file, 2022-04-18]
FreeCad/spaceship_laser2.FCStd
20.0 x 8.00 x 8.00 mm
