meh2481/picopinball/FreeCad/slingshot_switch3.FCStd

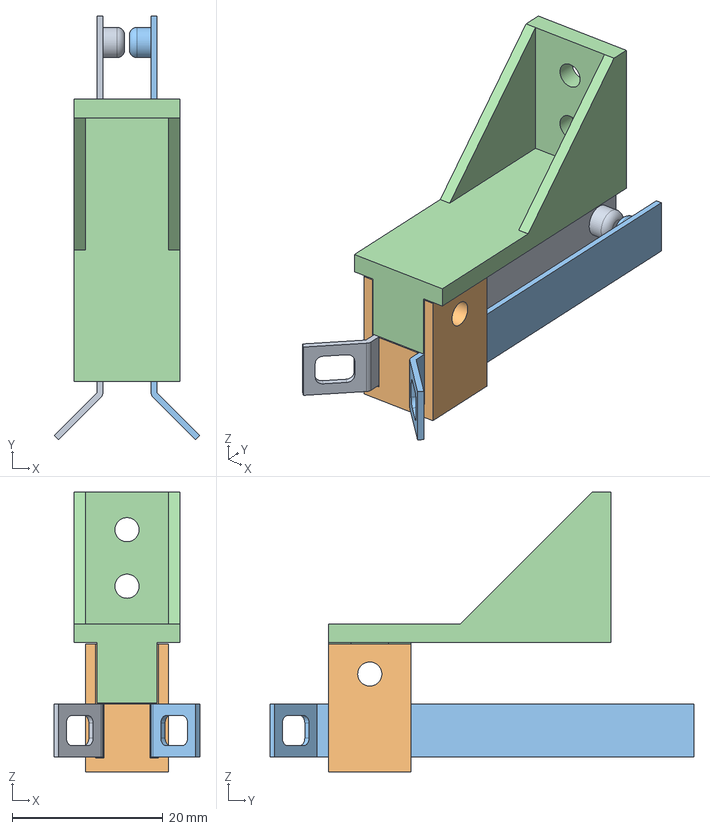
[picture p56: CAD file, 2022-04-18]
FreeCad/slingshot_switch3.FCStd
19.3 x 56.2 x 37.1 mm
switchPaddle
paddleSpacer2
switchPaddle001
paddleBracket
