meh2481/picopinball/FreeCad/solenoidBracket.FCStd

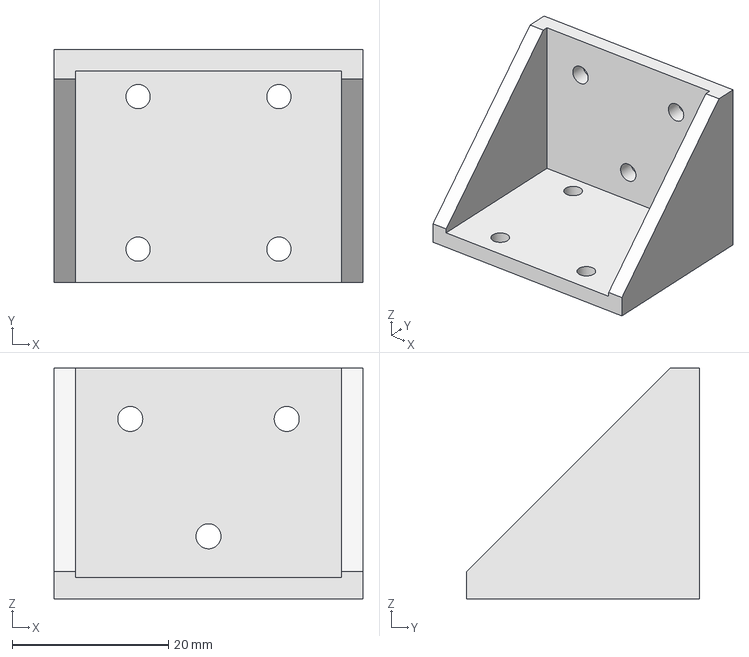
[picture p57: CAD file, 2022-04-18]
FreeCad/solenoidBracket.FCStd
39.5 x 29.8 x 29.5 mm
