meh2481/picopinball/FreeCad/slingshot_solenoidBracket.FCStd

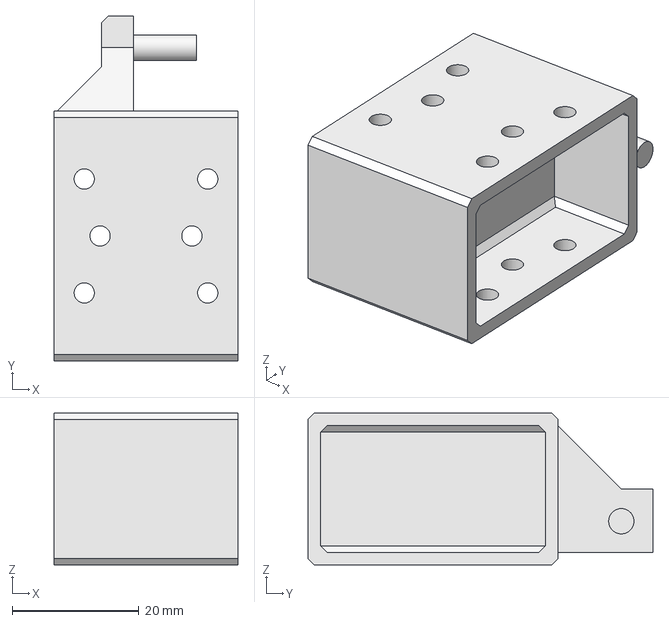
[picture p58: CAD file, 2022-04-18]
FreeCad/slingshot_solenoidBracket.FCStd
29.0 x 54.5 x 24.0 mm
