meh2481/picopinball/FreeCad/centralLights.FCStd

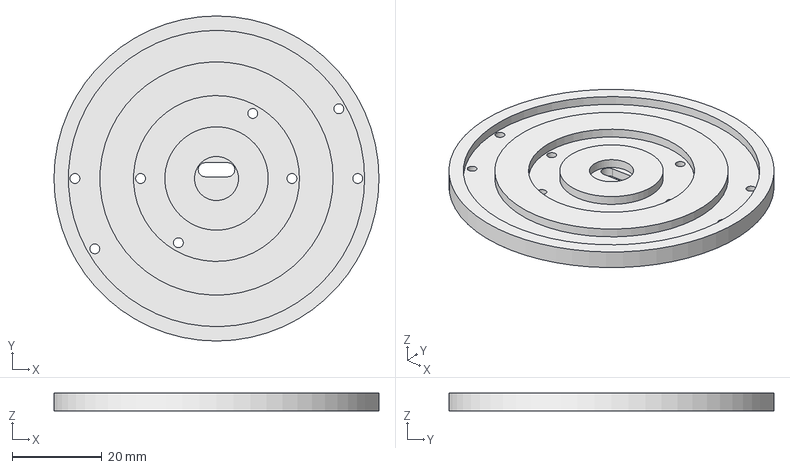
[picture p59: CAD file, 2022-04-18]
FreeCad/centralLights.FCStd
72.3 x 72.3 x 4.00 mm
