meh2481/picopinball/FreeCad/testboard2.FCStd

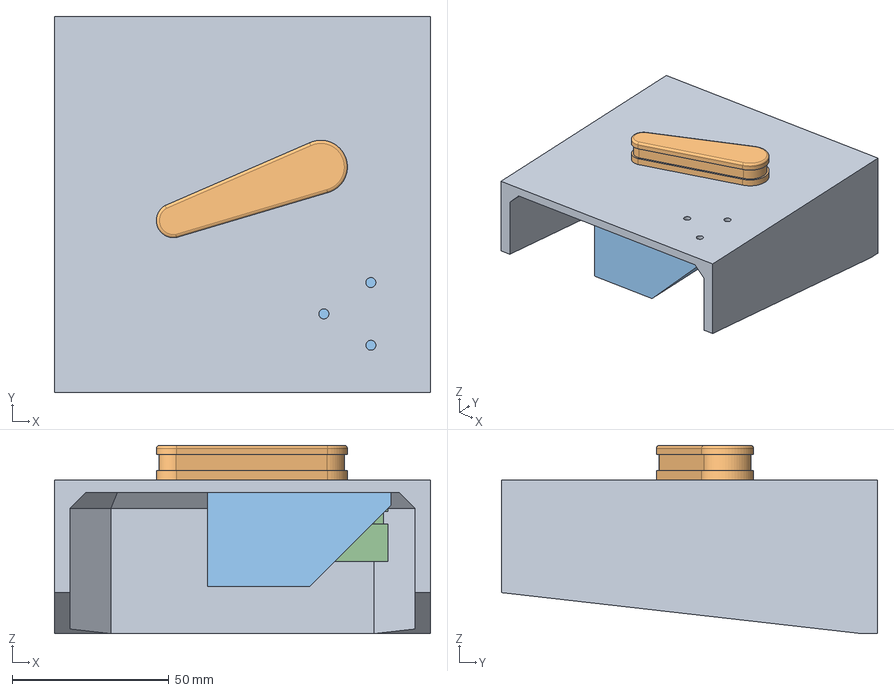
[picture p60: CAD file, 2022-04-18]
FreeCad/testboard2.FCStd
120.0 x 120.0 x 60.1 mm
Flipper
solenoidMockup
flipper_underside
flipperSpringMockup
