meh2481/picopinball/FreeCad/flipperSpringMockup.FCStd

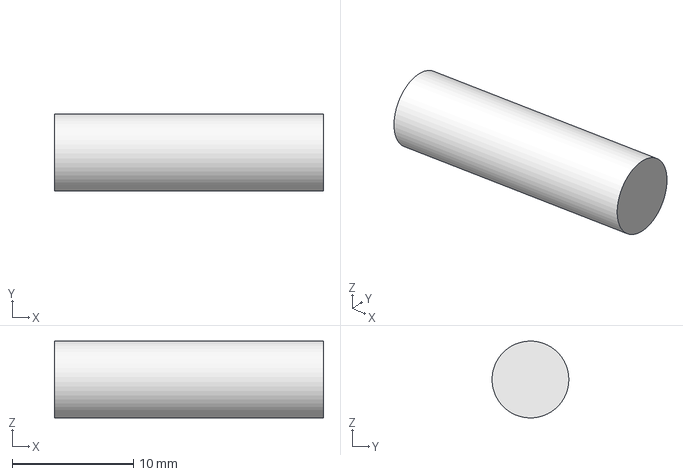
[picture p61: CAD file, 2022-04-18]
FreeCad/flipperSpringMockup.FCStd
22.2 x 6.34 x 6.35 mm
