meh2481/picopinball/FreeCad/pinballSpinner.FCStd

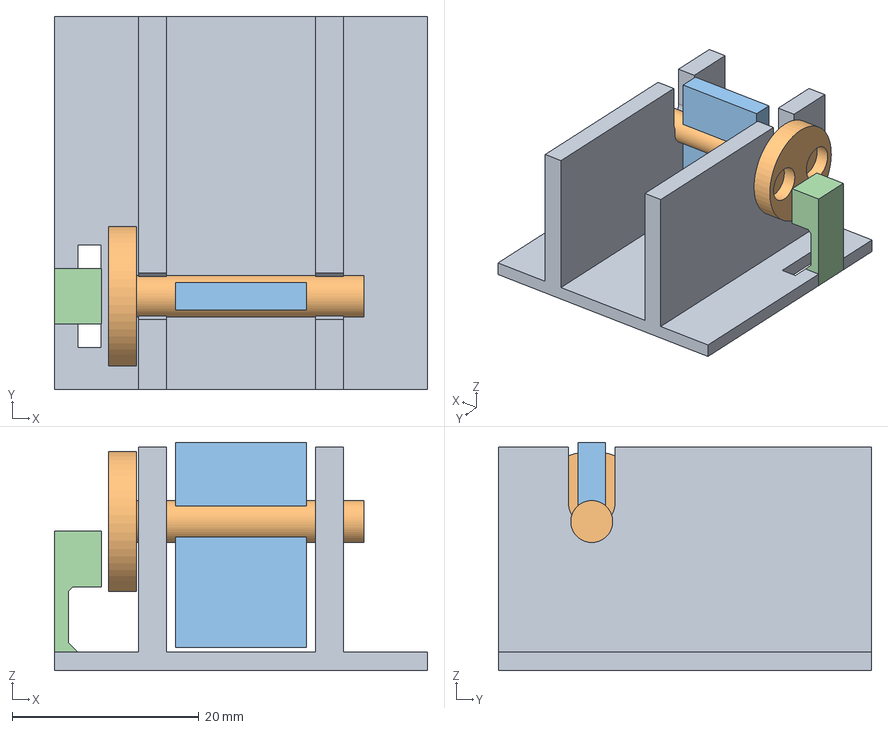
[picture p62: CAD file, 2022-04-18]
FreeCad/pinballSpinner.FCStd
40.0 x 40.0 x 24.5 mm
testBoard
peg
spinner
hallSensorHolder
