meh2481/picopinball/FreeCad/hallSensorTester.FCStd

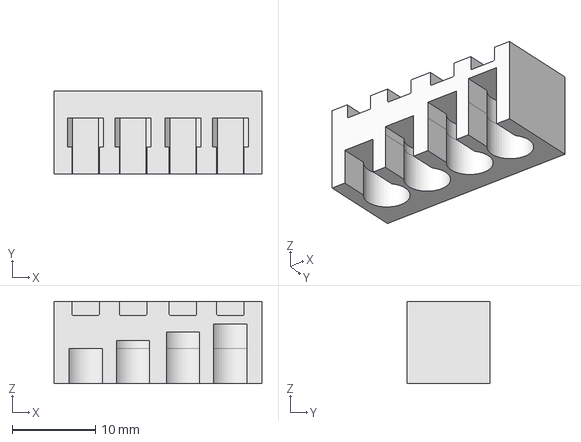
[picture p63: CAD file, 2022-04-18]
FreeCad/hallSensorTester.FCStd
25.0 x 10.0 x 9.90 mm
