meh2481/picopinball/FreeCad/popBumperSensorCover.FCStd

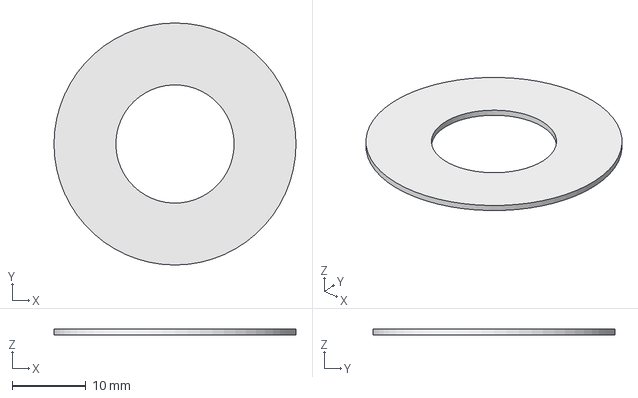
[picture p64: CAD file, 2022-04-18]
FreeCad/popBumperSensorCover.FCStd
32.8 x 32.8 x 0.75 mm
