meh2481/picopinball/FreeCad/irSensorTestStand.FCStd

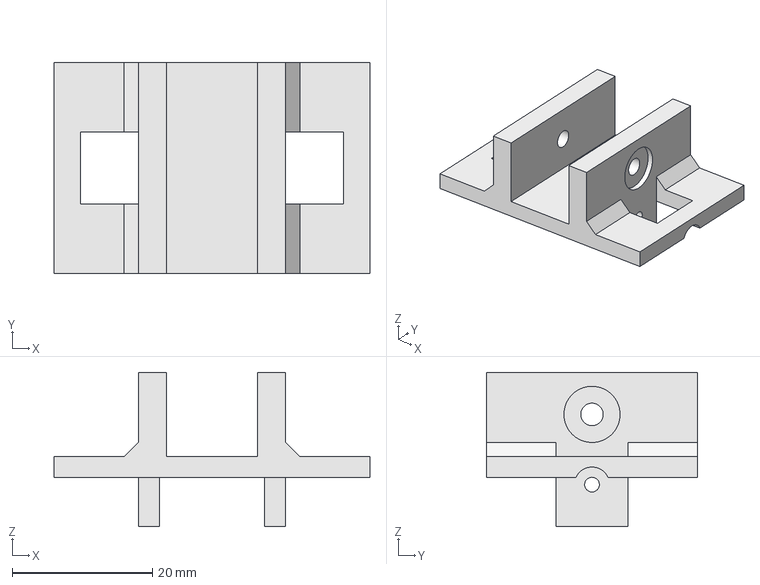
[picture p65: CAD file, 2022-04-18]
FreeCad/irSensorTestStand.FCStd
45.0 x 30.0 x 22.0 mm
