meh2481/picopinball/FreeCad/slingshot.FCStd

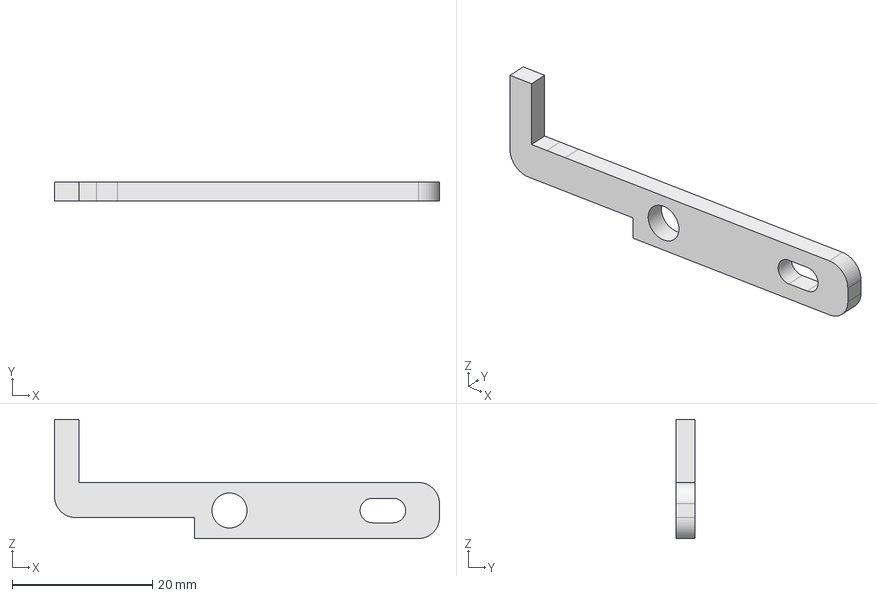
[picture p66: CAD file, 2022-04-18]
FreeCad/slingshot.FCStd
55.0 x 2.75 x 17.0 mm
