meh2481/picopinball/FreeCad/switchTestBoard.FCStd

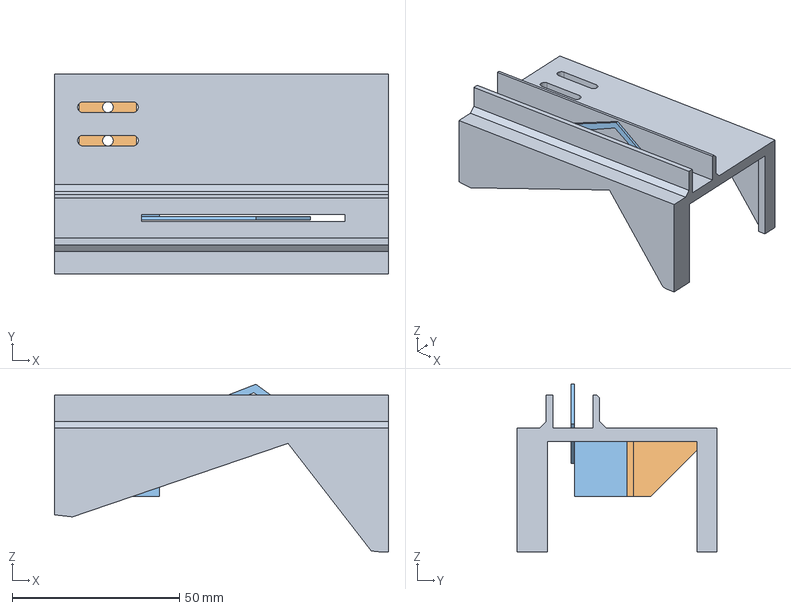
[picture p67: CAD file, 2022-04-18]
FreeCad/switchTestBoard.FCStd
100.0 x 60.0 x 50.2 mm
switchBracket
mockSwitch
