meh2481/picopinball/FreeCad/popBumperSensor.FCStd

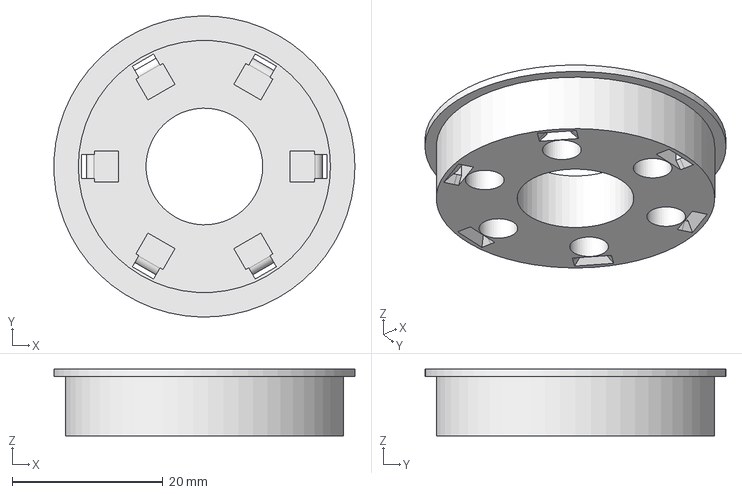
[picture p68: CAD file, 2022-04-18]
FreeCad/popBumperSensor.FCStd
40.0 x 40.0 x 8.90 mm
