meh2481/picopinball/FreeCad/popBumperSensor3.FCStd

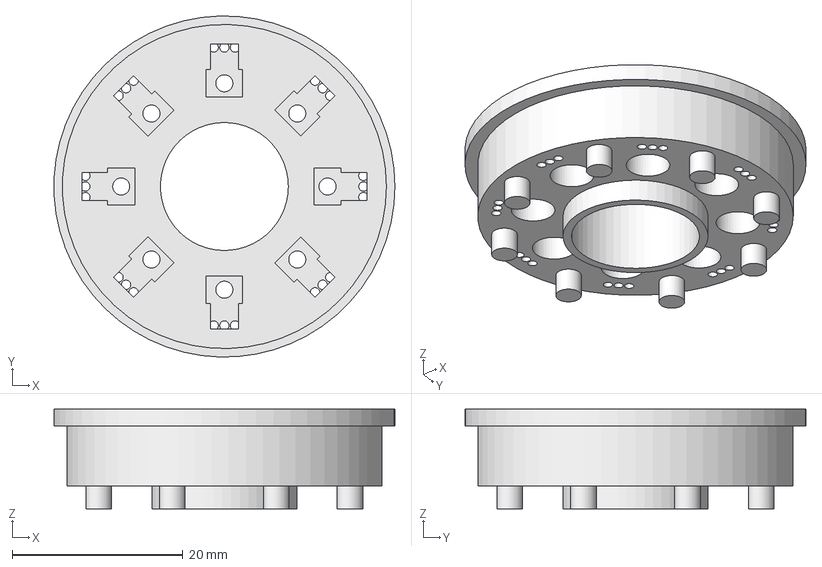
[picture p69: CAD file, 2022-04-18]
FreeCad/popBumperSensor3.FCStd
40.0 x 40.0 x 11.7 mm
