meh2481/picopinball/FreeCad/spaceship_laser.FCStd

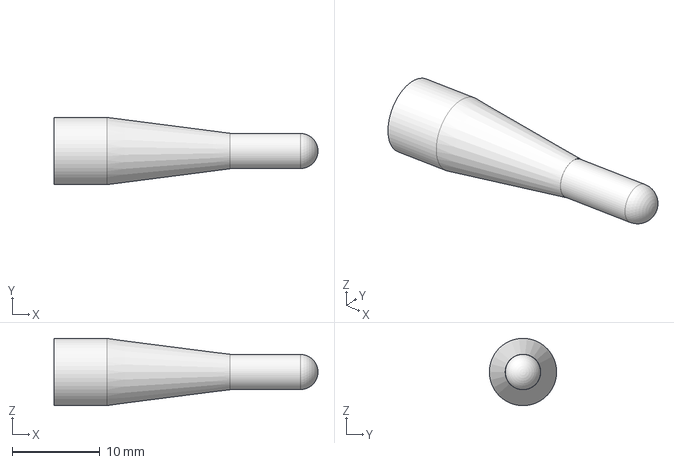
[picture p70: CAD file, 2022-04-18]
FreeCad/spaceship_laser.FCStd
30.0 x 7.64 x 7.65 mm
