meh2481/picopinball/FreeCad/slingshot_switch2.FCStd

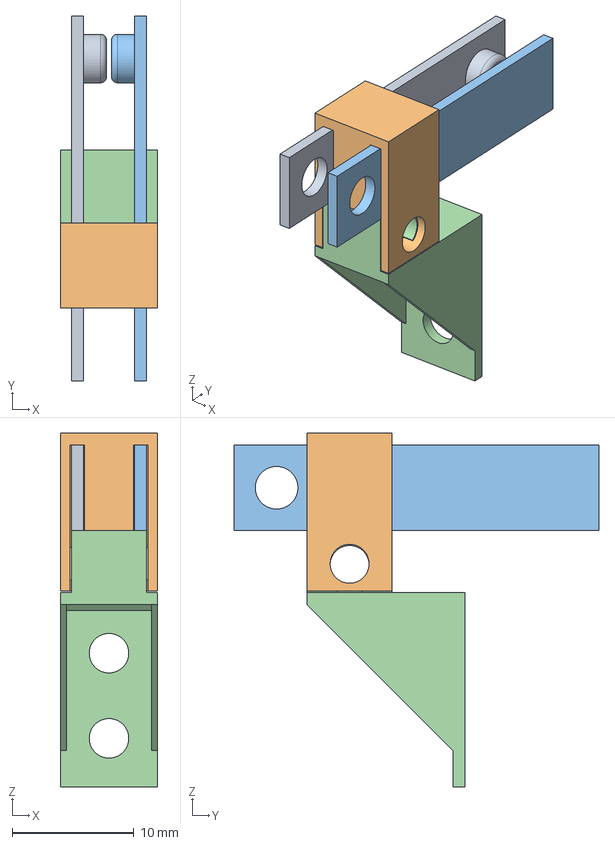
[picture p71: CAD file, 2022-04-18]
FreeCad/slingshot_switch2.FCStd
8.00 x 30.0 x 29.1 mm
switchPaddle
paddleSpacer
switchPaddle001
screwHolder
