meh2481/picopinball/FreeCad/popBumperSensorCover2.FCStd

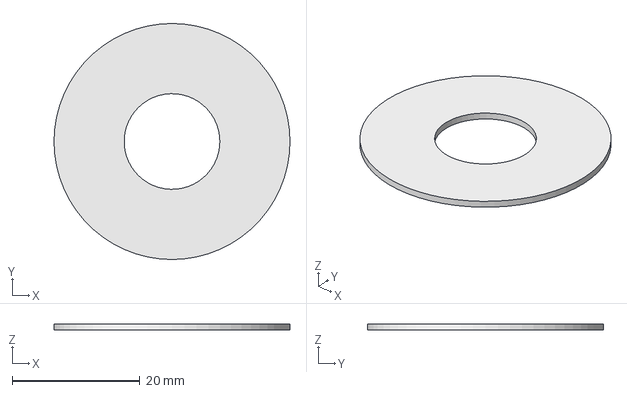
[picture p72: CAD file, 2022-04-18]
FreeCad/popBumperSensorCover2.FCStd
37.0 x 37.0 x 1.00 mm
