meh2481/picopinball/FreeCad/popBumperSolenoidBracket2.FCStd

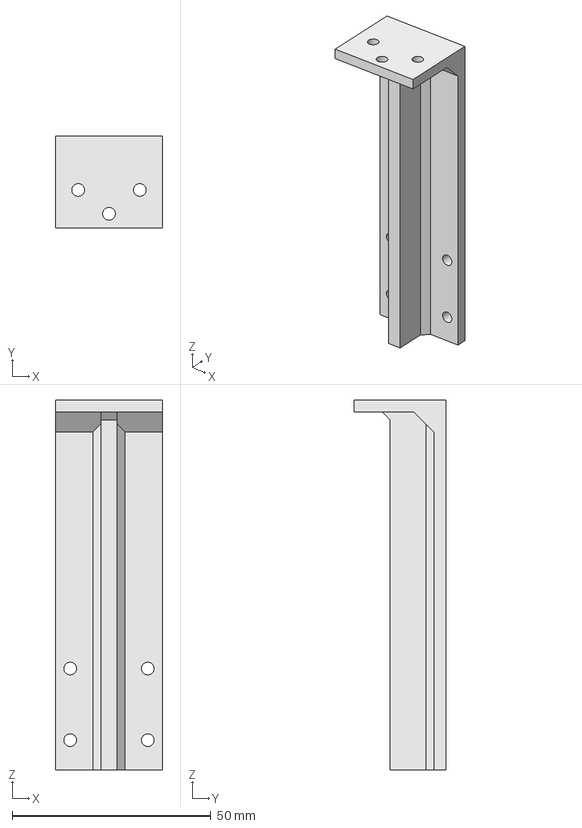
[picture p73: CAD file, 2022-04-18]
FreeCad/popBumperSolenoidBracket2.FCStd
27.0 x 23.0 x 93.0 mm
