meh2481/picopinball/FreeCad/slingshot_switch.FCStd

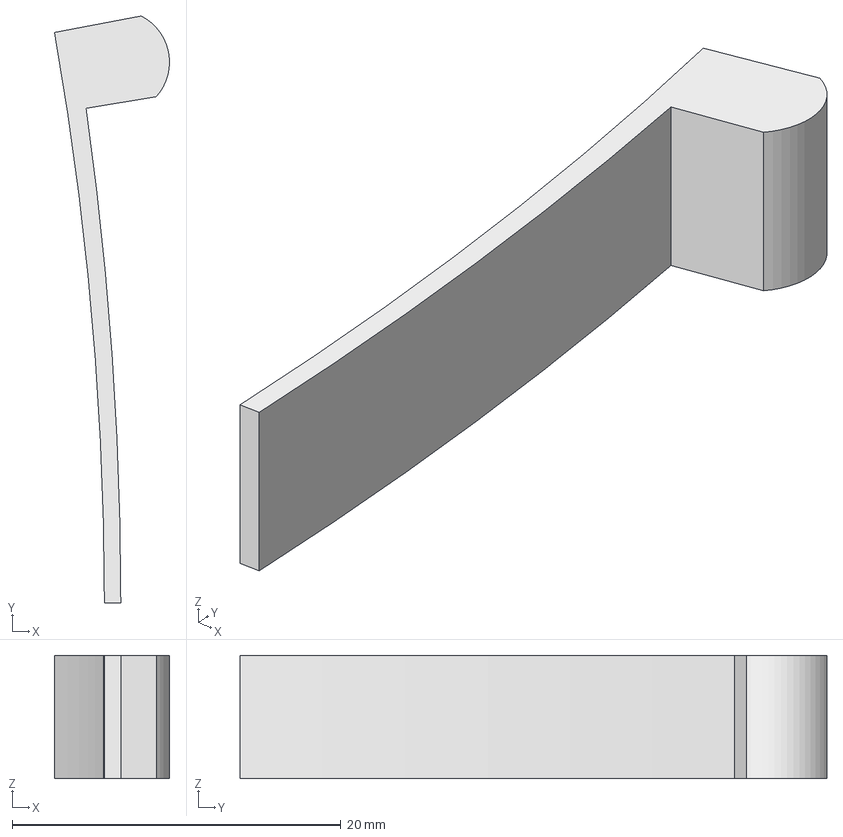
[picture p74: CAD file, 2022-04-18]
FreeCad/slingshot_switch.FCStd
7.00 x 35.7 x 7.50 mm
