meh2481/picopinball/FreeCad/spaceship_postHolder.FCStd

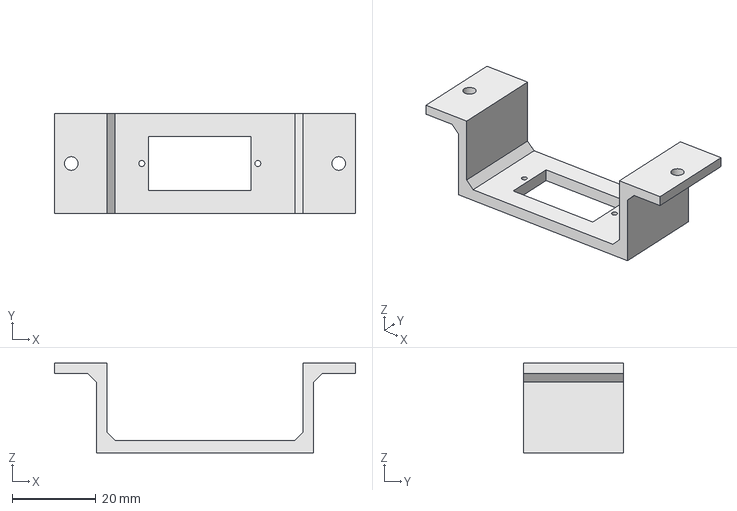
[picture p75: CAD file, 2022-04-18]
FreeCad/spaceship_postHolder.FCStd
72.0 x 24.0 x 21.5 mm
