meh2481/picopinball/FreeCad/flipper.FCStd

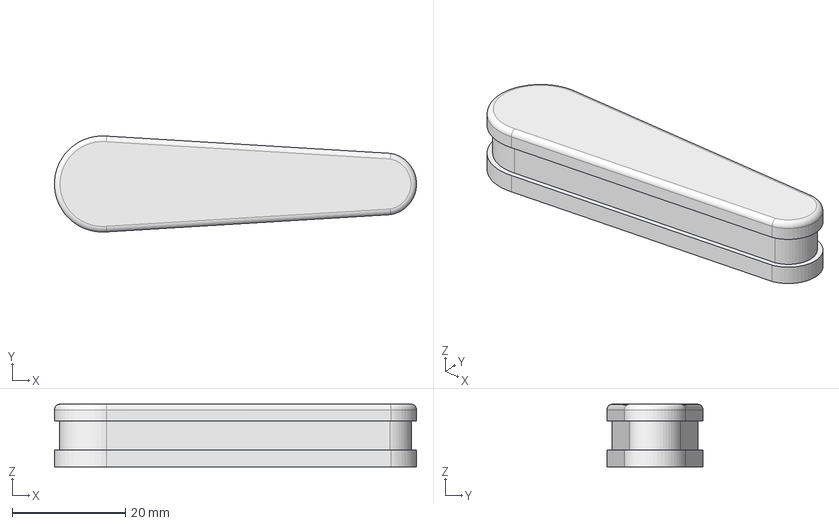
[picture p76: CAD file, 2022-04-18]
FreeCad/flipper.FCStd
64.0 x 17.0 x 11.1 mm
