meh2481/picopinball/(list of files, cad)

Other CAD files:
FreeCad/popBumperSensor2.FCStd
FreeCad/circleLightHolder-old.FCStd
