meh2481/picopinball/KiCad/ScoreController/ScoreController/ScoreController.kicad_pcb

## KiCad design KiCad/ScoreController/ScoreController/ScoreController.kicad_pcb (2022-11-01)

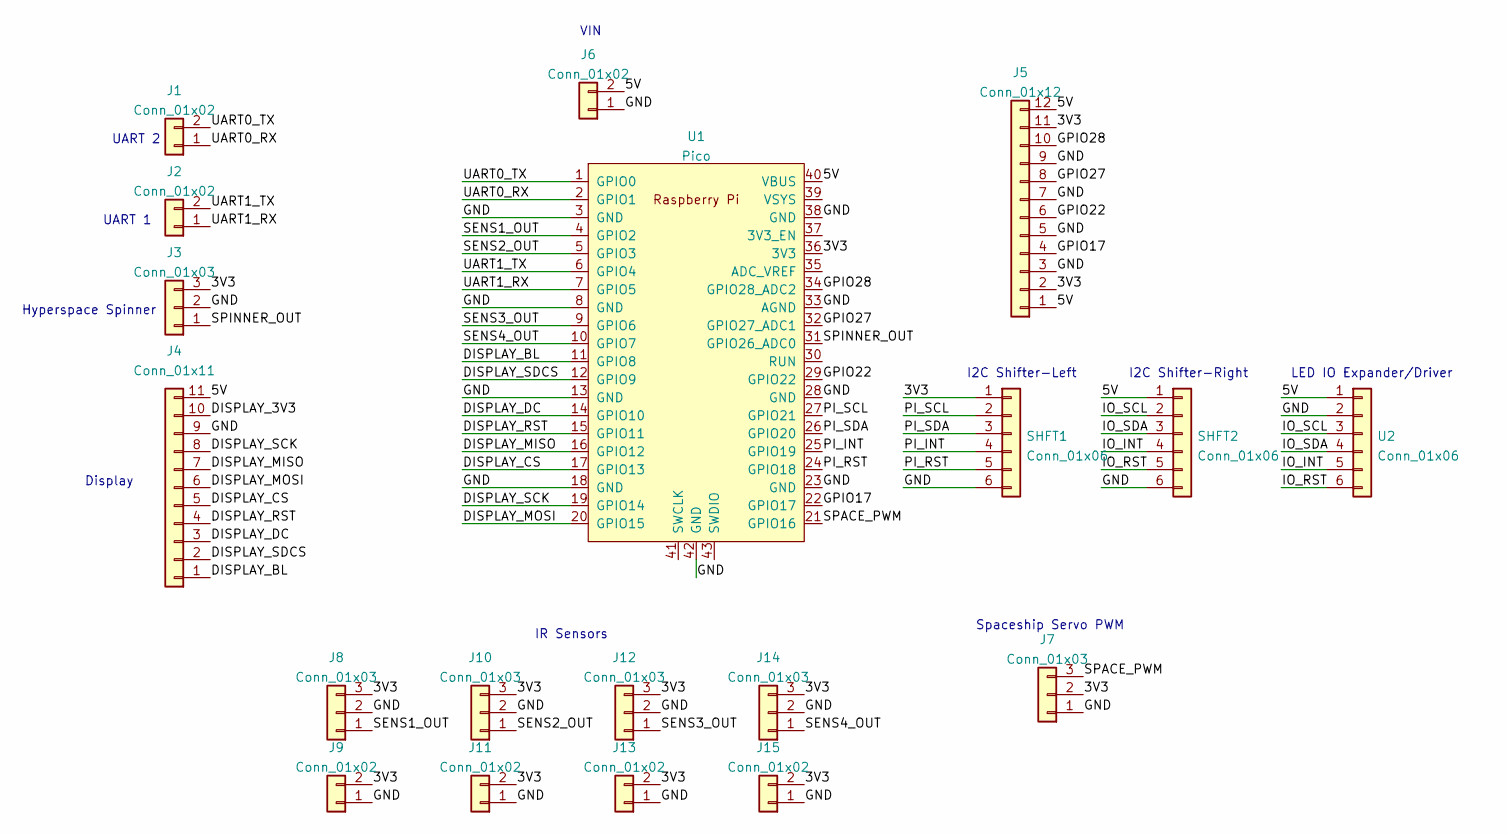
[picture p77: schematic ScoreController.kicad_sch]

Parts:
J1, J2, J9, J11, J13, J15: Conn_01x02; JST_XH_B2B-XH-A_1x02_P2.50mm_Vertical
J3, J8, J10, J12, J14: Conn_01x03; JST_XH_B3B-XH-A_1x03_P2.50mm_Vertical
J4: Conn_01x11; PinHeader_1x11_P2.54mm_Vertical
J5: Conn_01x12; TerminalBlock_Phoenix_MPT-0,5-12-2.54_1x12_P2.54mm_Horizont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
J6: Conn_01x02; TerminalBlock_4Ucon_1x02_P3.50mm_Horizontal
J7: Conn_01x03; PinHeader_1x03_P2.54mm_Vertical
SHFT1, SHFT2: Conn_01x06; PinHeader_1x06_P2.54mm_Vertical
U1: Pico; RPi_Pico_SMD
U2: Conn_01x06; PinHeader_1x06_P2.54mm_Vertical

Connections:
/3V3: J3.3, J5.2, J5.11, J7.2, J8.3, J9.2, J10.3, J11.2, J12.3, J13.2, J14.3, J15.2, SHFT1.1, U1.36 (3V3)
/5V: J4.11, J5.1, J5.12, J6.2, SHFT2.1, U1.40 (VBUS), U2.1
/DISPLAY_3V3: J4.10
/DISPLAY_BL: J4.1, U1.11 (GPIO8)
/DISPLAY_CS: J4.5, U1.17 (GPIO13)
/DISPLAY_DC: J4.3, U1.14 (GPIO10)
/DISPLAY_MISO: J4.7, U1.16 (GPIO12)
/DISPLAY_MOSI: J4.6, U1.20 (GPIO15)
/DISPLAY_RST: J4.4, U1.15 (GPIO11)
/DISPLAY_SCK: J4.8, U1.19 (GPIO14)
/DISPLAY_SDCS: J4.2, U1.12 (GPIO9)
/GND: J3.2, J4.9, J5.3, J5.5, J5.7, J5.9, J6.1, J7.1, J8.2, J9.1, J10.2, J11.1, J12.2, J13.1, J14.2, J15.1, SHFT1.6, SHFT2.6, U1.3 (GND), U1.8 (GND), U1.13 (GND), U1.18 (GND), U1.23 (GND), U1.28 (GND), U1.33 (AGND), U1.38 (GND), U1.42 (GND), U2.2
/GPIO17: J5.4, U1.22 (GPIO17)
/GPIO22: J5.6, U1.29 (GPIO22)
/GPIO27: J5.8, U1.32 (GPIO27_ADC1)
/GPIO28: J5.10, U1.34 (GPIO28_ADC2)
/IO_INT: SHFT2.4, U2.5
/IO_RST: SHFT2.5, U2.6
/IO_SCL: SHFT2.2, U2.3
/IO_SDA: SHFT2.3, U2.4
/PI_INT: SHFT1.4, U1.25 (GPIO19)
/PI_RST: SHFT1.5, U1.24 (GPIO18)
/PI_SCL: SHFT1.2, U1.27 (GPIO21)
/PI_SDA: SHFT1.3, U1.26 (GPIO20)
/SENS1_OUT: J8.1, U1.4 (GPIO2)
/SENS2_OUT: J10.1, U1.5 (GPIO3)
/SENS3_OUT: J12.1, U1.9 (GPIO6)
/SENS4_OUT: J14.1, U1.10 (GPIO7)
/SPACE_PWM: J7.3, U1.21 (GPIO16)
/SPINNER_OUT: J3.1, U1.31 (GPIO26_ADC0)
/UART0_RX: J1.1, U1.2 (GPIO1)
/UART0_TX: J1.2, U1.1 (GPIO0)
/UART1_RX: J2.1, U1.7 (GPIO5)
/UART1_TX: J2.2, U1.6 (GPIO4)

Notes on the sheet:
IR Sensors
Display
I2C Shifter-Right
I2C Shifter-Left
Hyperspace Spinner
Spaceship Servo PWM
UART 2
LED IO Expander/Driver
UART 1
VIN

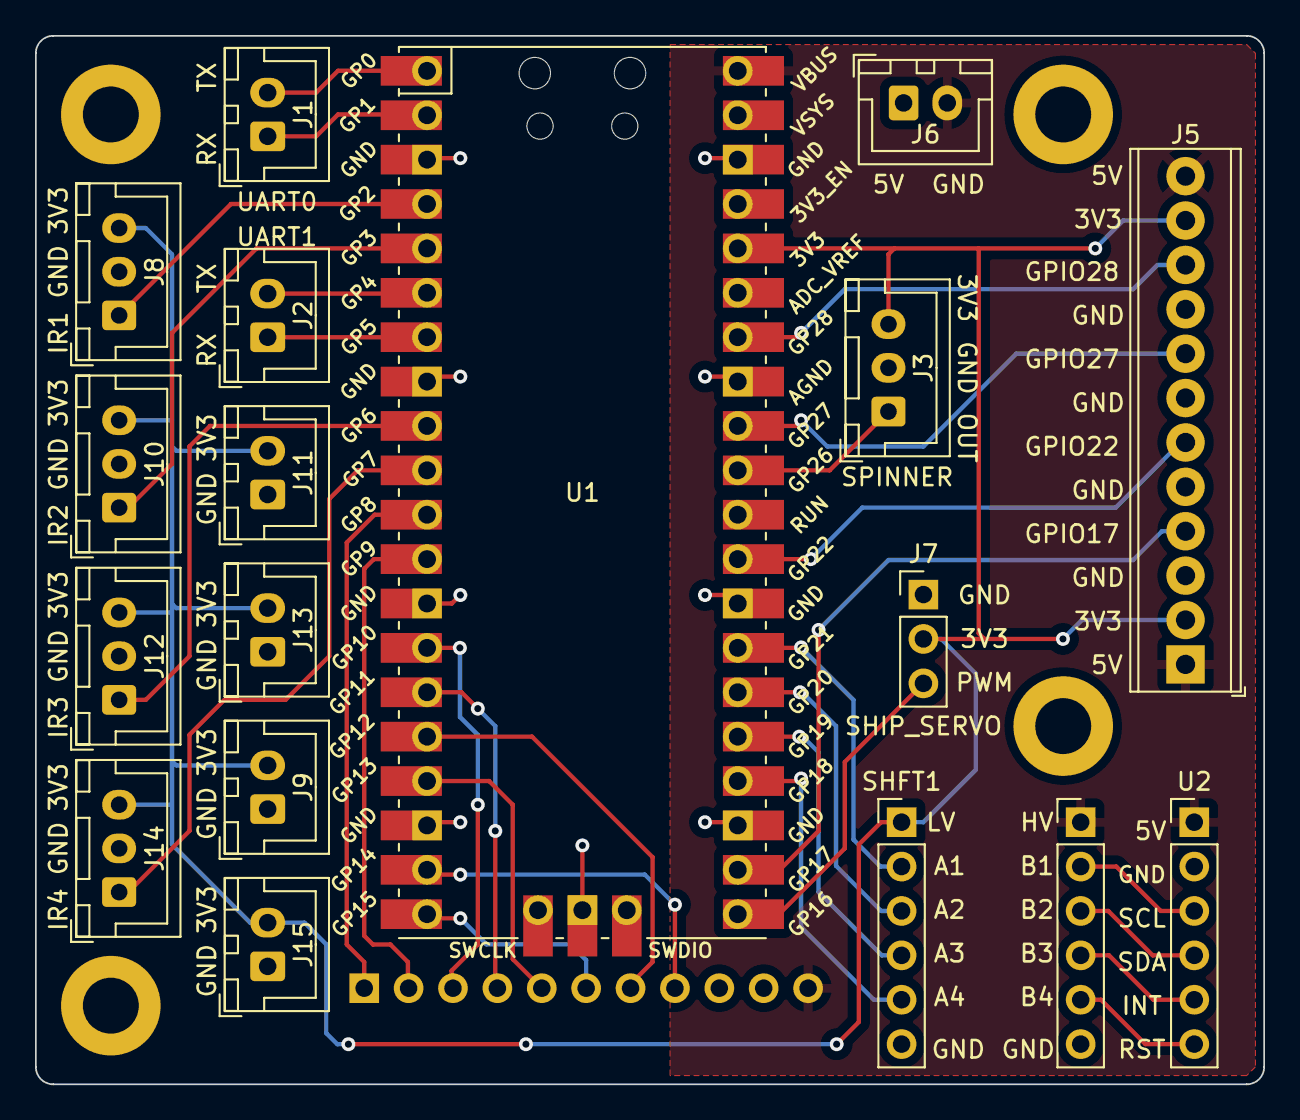
[picture p78: board ScoreController.kicad_pcb from above]

Board: 2 copper layers, 70.3 x 60.0 mm, 23 parts (1 on the bottom side), 33 nets.

Other parts of the board:
HOLE1, HOLE1#2, HOLE2, HOLE2#2: MountingHole_3.2mm_M3_ISO7380_Pad
