meh2481/picopinball/KiCad/PopBumperController/PopBumperController/PopBumperController.kicad_pcb

## KiCad design KiCad/PopBumperController/PopBumperController/PopBumperController.kicad_pcb (2022-09-14)

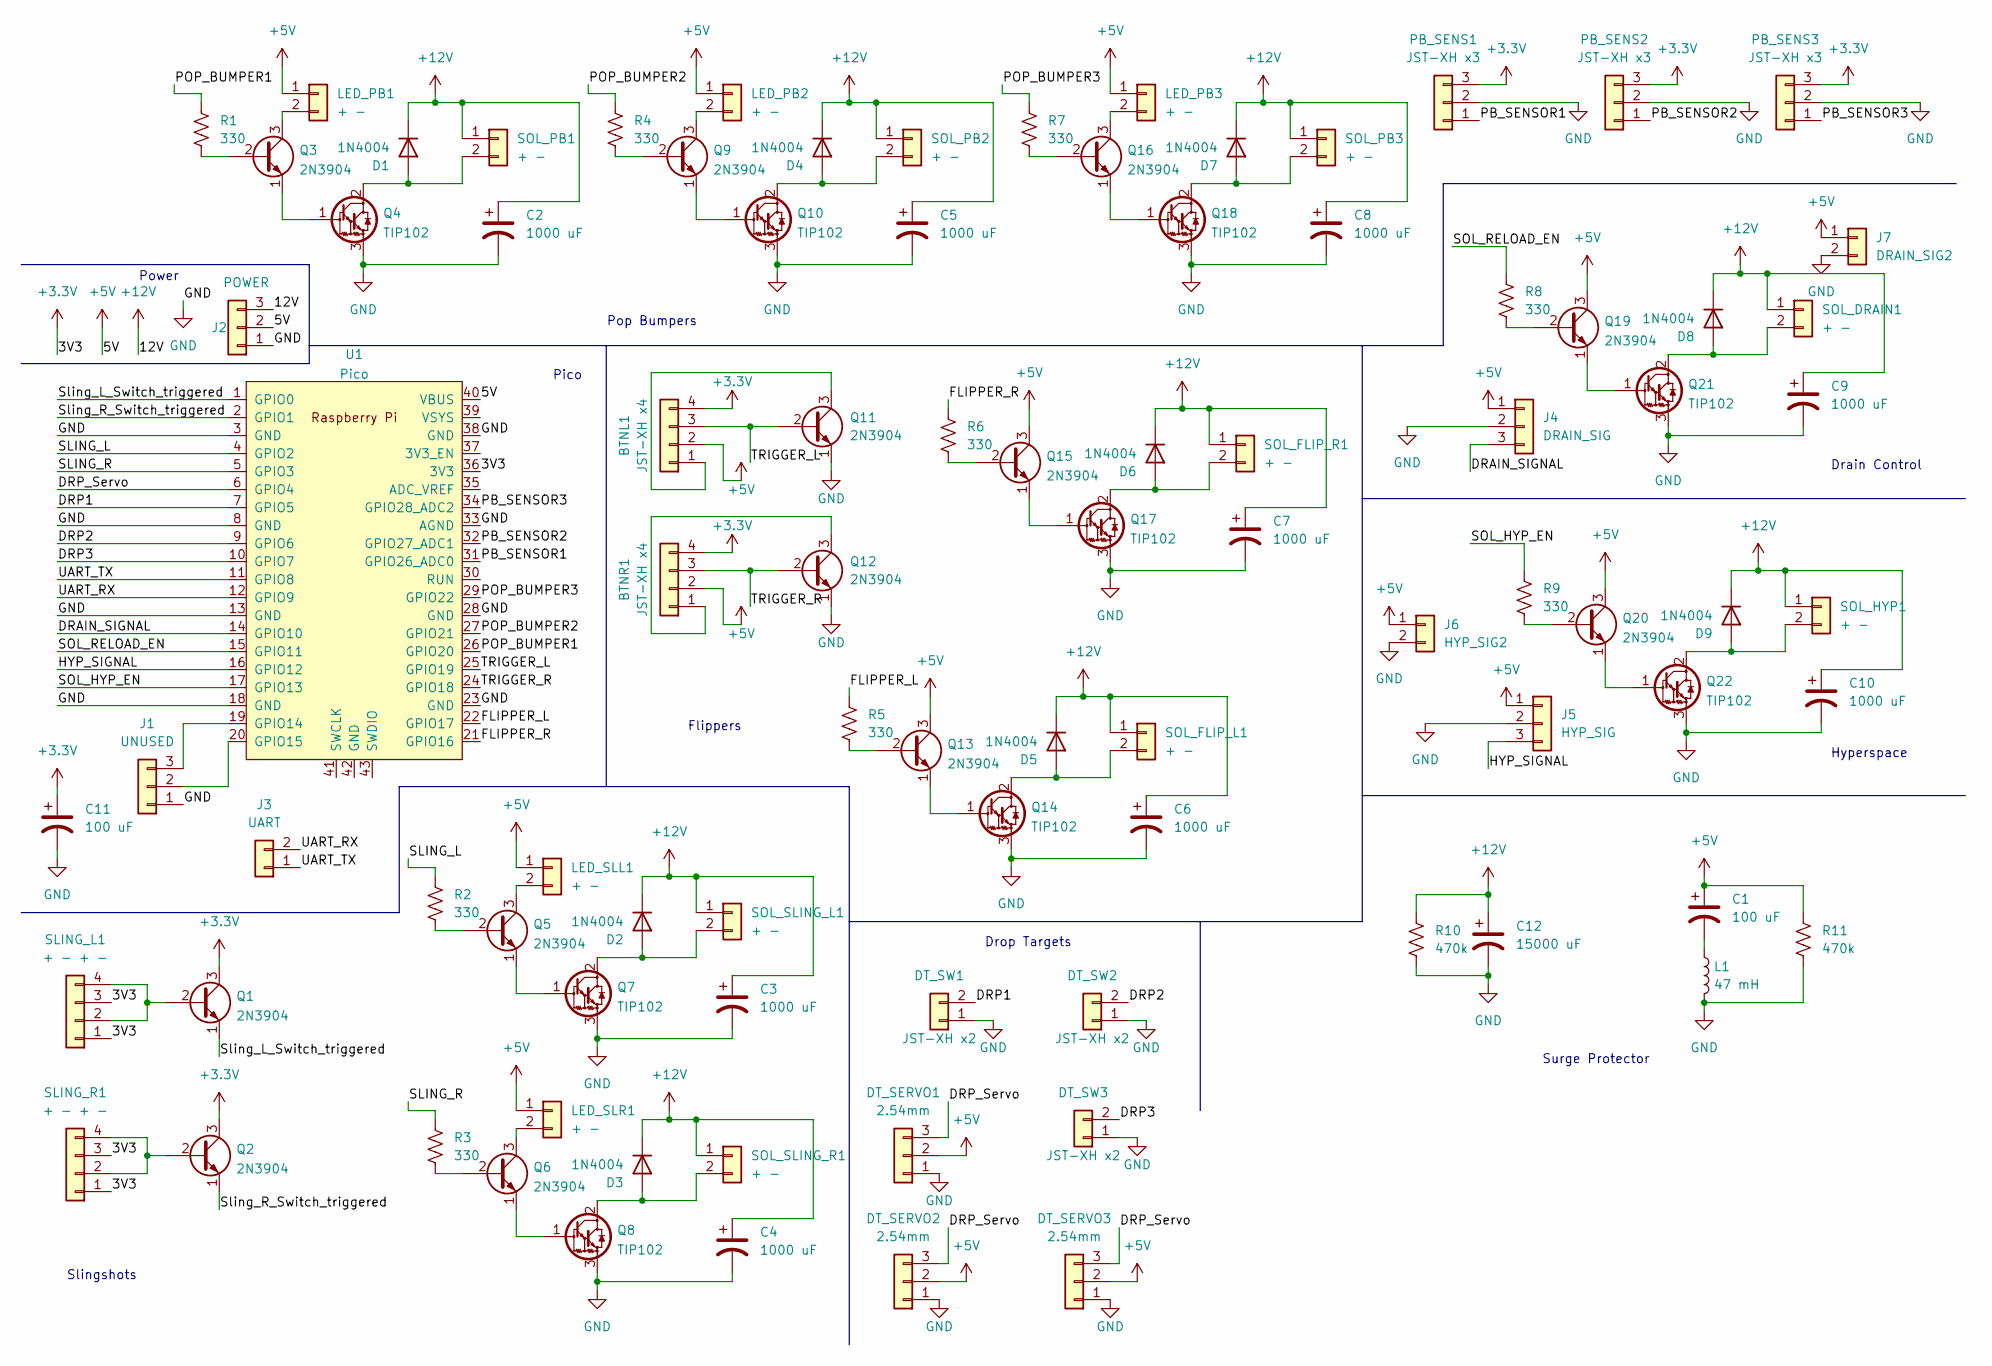
[picture p79: schematic PopBumperController.kicad_sch]

Parts:
BTNL1: JST-XH x4; JST_XH_B4B-XH-A_1x04_P2.50mm_Vertical
BTNR1: JST-XH x4; JST_XH_B4B-XH-A_1x04_P2.50mm_Vertical
C1, C11: 100 uF; CP_Radial_D8.0mm_P3.50mm
C2, C3, C4, C5, C6, C7, C8, C9, C10: 1000 uF; CP_Radial_D10.0mm_P5.00mm
C12: 15000 uF; CP_Radial_D25.0mm_P10.00mm_SnapIn
D1, D2, D3, D4, D5, D6, D7, D8, D9: 1N4004; D_DO-41_SOD81_P10.16mm_Horizontal
DT_SERVO1, DT_SERVO2, DT_SERVO3: 2.54mm; PinHeader_1x03_P2.54mm_Vertical
DT_SW1, DT_SW2, DT_SW3: JST-XH x2; JST_XH_B2B-XH-A_1x02_P2.50mm_Vertical
J1: UNUSED; JST_XH_B3B-XH-A_1x03_P2.50mm_Vertical
J2: POWER; JST_XH_B3B-XH-A_1x03_P2.50mm_Vertical
J3: UART; JST_XH_B2B-XH-A_1x02_P2.50mm_Vertical
J4: DRAIN_SIG; JST_XH_B3B-XH-A_1x03_P2.50mm_Vertical
J5: HYP_SIG; JST_XH_B3B-XH-A_1x03_P2.50mm_Vertical
J6: HYP_SIG2; JST_XH_B2B-XH-A_1x02_P2.50mm_Vertical
J7: DRAIN_SIG2; JST_XH_B2B-XH-A_1x02_P2.50mm_Vertical
L1: 47 mH; L_Radial_D12.0mm_P5.00mm_Fastron_11P
LED_PB1, LED_PB2, LED_PB3: + -; JST_XH_B2B-XH-A_1x02_P2.50mm_Vertical
LED_SLL1: + -; JST_XH_B2B-XH-A_1x02_P2.50mm_Vertical
LED_SLR1: + -; JST_XH_B2B-XH-A_1x02_P2.50mm_Vertical
PB_SENS1, PB_SENS2, PB_SENS3: JST-XH x3; JST_XH_B3B-XH-A_1x03_P2.50mm_Vertical
Q1, Q2, Q3, Q5, Q6, Q9, Q11, Q12, Q13, Q15, Q16, Q19, Q20: 2N3904; TO-92_Inline
Q4, Q7, Q8, Q10, Q14, Q17, Q18, Q21, Q22: TIP102; TO-220-3_Vertical
R1, R2, R3, R4, R5, R6, R7, R8, R9: 330; R_Axial_DIN0309_L9.0mm_D3.2mm_P12.70mm_Horizontal
R10, R11: 470k; R_Axial_DIN0309_L9.0mm_D3.2mm_P12.70mm_Horizontal
SLING_L1: + - + -; JST_XH_B4B-XH-A_1x04_P2.50mm_Vertical
SLING_R1: + - + -; JST_XH_B4B-XH-A_1x04_P2.50mm_Vertical
SOL_DRAIN1: + -; JST_XH_B2B-XH-A_1x02_P2.50mm_Vertical
SOL_FLIP_L1: + -; JST_XH_B2B-XH-A_1x02_P2.50mm_Vertical
SOL_FLIP_R1: + -; JST_XH_B2B-XH-A_1x02_P2.50mm_Vertical
SOL_HYP1: + -; JST_XH_B2B-XH-A_1x02_P2.50mm_Vertical
SOL_PB1, SOL_PB2, SOL_PB3: + -; JST_XH_B2B-XH-A_1x02_P2.50mm_Vertical
SOL_SLING_L1: + -; JST_XH_B2B-XH-A_1x02_P2.50mm_Vertical
SOL_SLING_R1: + -; JST_XH_B2B-XH-A_1x02_P2.50mm_Vertical
U1: Pico; RPi_Pico_TH

Connections:
+3V3: BTNL1.4, BTNR1.4, C11.1, PB_SENS1.3, PB_SENS2.3, PB_SENS3.3, Q1.3 (C), Q2.3 (C), SLING_L1.1, SLING_L1.3, SLING_R1.1, SLING_R1.3, U1.36 (3V3); also elsewhere on the board
+5V: BTNL1.2, BTNR1.2, C1.1, DT_SERVO1.2, DT_SERVO2.2, DT_SERVO3.2, J2.2, J4.1, J5.1, J6.1, J7.1, LED_PB1.1, LED_PB2.1, LED_PB3.1, LED_SLL1.1, LED_SLR1.1, Q13.3 (C), Q15.3 (C), Q19.3 (C), Q20.3 (C), R11.1, U1.40 (VBUS); also elsewhere on the board
+12V: C2.1, C3.1, C4.1, C5.1, C6.1, C7.1, C8.1, C9.1, C10.1, C12.1, D1.1 (K), D2.1 (K), D3.1 (K), D4.1 (K), D5.1 (K), D6.1 (K), D7.1 (K), D8.1 (K), D9.1 (K), J2.3, R10.1, SOL_DRAIN1.1, SOL_FLIP_L1.1, SOL_FLIP_R1.1, SOL_HYP1.1, SOL_PB1.1, SOL_PB2.1, SOL_PB3.1, SOL_SLING_L1.1, SOL_SLING_R1.1; also elsewhere on the board
/DRAIN_SIGNAL: J4.3, U1.14 (GPIO10)
/DRP1: DT_SW1.2, U1.7 (GPIO5)
/DRP2: DT_SW2.2, U1.9 (GPIO6)
/DRP3: DT_SW3.2, U1.10 (GPIO7)
/DRP_Servo: DT_SERVO1.3, DT_SERVO2.3, DT_SERVO3.3, U1.6 (GPIO4)
/FLIPPER_L: R5.1, U1.22 (GPIO17)
/FLIPPER_R: R6.1, U1.21 (GPIO16)
/HYP_SIGNAL: J5.3, U1.16 (GPIO12)
/PB_SENSOR1: PB_SENS1.1, U1.31 (GPIO26_ADC0)
/PB_SENSOR2: PB_SENS2.1, U1.32 (GPIO27_ADC1)
/PB_SENSOR3: PB_SENS3.1, U1.34 (GPIO28_ADC2)
/POP_BUMPER1: R1.1, U1.26 (GPIO20)
/POP_BUMPER2: R4.1, U1.27 (GPIO21)
/POP_BUMPER3: R7.1, U1.29 (GPIO22)
/SLING_L: R2.1, U1.4 (GPIO2)
/SLING_R: R3.1, U1.5 (GPIO3)
/SOL_HYP_EN: R9.1, U1.17 (GPIO13)
/SOL_RELOAD_EN: R8.1, U1.15 (GPIO11)
/Sling_L_Switch_triggered: Q1.1 (E), U1.1 (GPIO0)
/Sling_R_Switch_triggered: Q2.1 (E), U1.2 (GPIO1)
/TRIGGER_L: BTNL1.3, Q11.2 (B), U1.25 (GPIO19); also elsewhere on the board
/TRIGGER_R: BTNR1.3, Q12.2 (B), U1.24 (GPIO18); also elsewhere on the board
/UART_RX: J3.2, U1.12 (GPIO9)
/UART_TX: J3.1, U1.11 (GPIO8)
GND: C2.2, C3.2, C4.2, C5.2, C6.2, C7.2, C8.2, C9.2, C10.2, C11.2, C12.2, DT_SERVO1.1, DT_SERVO2.1, DT_SERVO3.1, DT_SW1.1, DT_SW2.1, DT_SW3.1, J1.1, J2.1, J4.2, J5.2, J6.2, J7.2, L1.2, PB_SENS1.2, PB_SENS2.2, PB_SENS3.2, Q4.3 (E), Q7.3 (E), Q8.3 (E), Q10.3 (E), Q11.1 (E), Q12.1 (E), Q14.3 (E), Q17.3 (E), Q18.3 (E), Q21.3 (E), Q22.3 (E), R10.2, R11.2, U1.3 (GND), U1.8 (GND), U1.13 (GND), U1.18 (GND), U1.23 (GND), U1.28 (GND), U1.33 (AGND), U1.38 (GND)
unnamed 28: BTNL1.1, Q11.3 (C); also elsewhere on the board
unnamed 29: BTNR1.1, Q12.3 (C); also elsewhere on the board
unnamed: C1.2, L1.1
unnamed: D2.2 (A), Q7.2 (C), SOL_SLING_L1.2
unnamed: D3.2 (A), Q8.2 (C), SOL_SLING_R1.2
unnamed: D4.2 (A), Q10.2 (C), SOL_PB2.2
unnamed 34: D5.2 (A), Q14.2 (C), SOL_FLIP_L1.2; also elsewhere on the board
unnamed: D6.2 (A), Q17.2 (C), SOL_FLIP_R1.2
unnamed: D7.2 (A), Q18.2 (C), SOL_PB3.2
unnamed: D8.2 (A), Q21.2 (C), SOL_DRAIN1.2
unnamed: D9.2 (A), Q22.2 (C), SOL_HYP1.2
unnamed: LED_PB1.2, Q3.3 (C)
unnamed: LED_PB2.2, Q9.3 (C)
unnamed: LED_PB3.2, Q16.3 (C)
unnamed: LED_SLL1.2, Q5.3 (C)
unnamed: LED_SLR1.2, Q6.3 (C)
unnamed: Q3.1 (E), Q4.1 (B)
unnamed: Q3.2 (B), R1.2
unnamed: Q5.1 (E), Q7.1 (B)
unnamed: Q5.2 (B), R2.2
unnamed: Q6.1 (E), Q8.1 (B)
unnamed: Q6.2 (B), R3.2
unnamed: Q9.2 (B), R4.2
unnamed: Q9.1 (E), Q10.1 (B)
unnamed: Q13.1 (E), Q14.1 (B)
unnamed: Q13.2 (B), R5.2
unnamed: Q15.1 (E), Q17.1 (B)
unnamed: Q15.2 (B), R6.2
unnamed: Q16.1 (E), Q18.1 (B)
unnamed: Q16.2 (B), R7.2
unnamed: Q19.1 (E), Q21.1 (B)
unnamed: Q19.2 (B), R8.2
unnamed: Q20.1 (E), Q22.1 (B)
unnamed: Q20.2 (B), R9.2
unnamed: Q1.2 (B), SLING_L1.2, SLING_L1.4
unnamed: Q2.2 (B), SLING_R1.2, SLING_R1.4
unnamed: D1.2 (A), Q4.2 (C), SOL_PB1.2
unnamed: J1.3, U1.19 (GPIO14)
unnamed: J1.2, U1.20 (GPIO15)

Notes on the sheet:
Pico
Surge Protector
Hyperspace
Flippers
Power
Drain Control
Slingshots
Drop Targets
Pop Bumpers

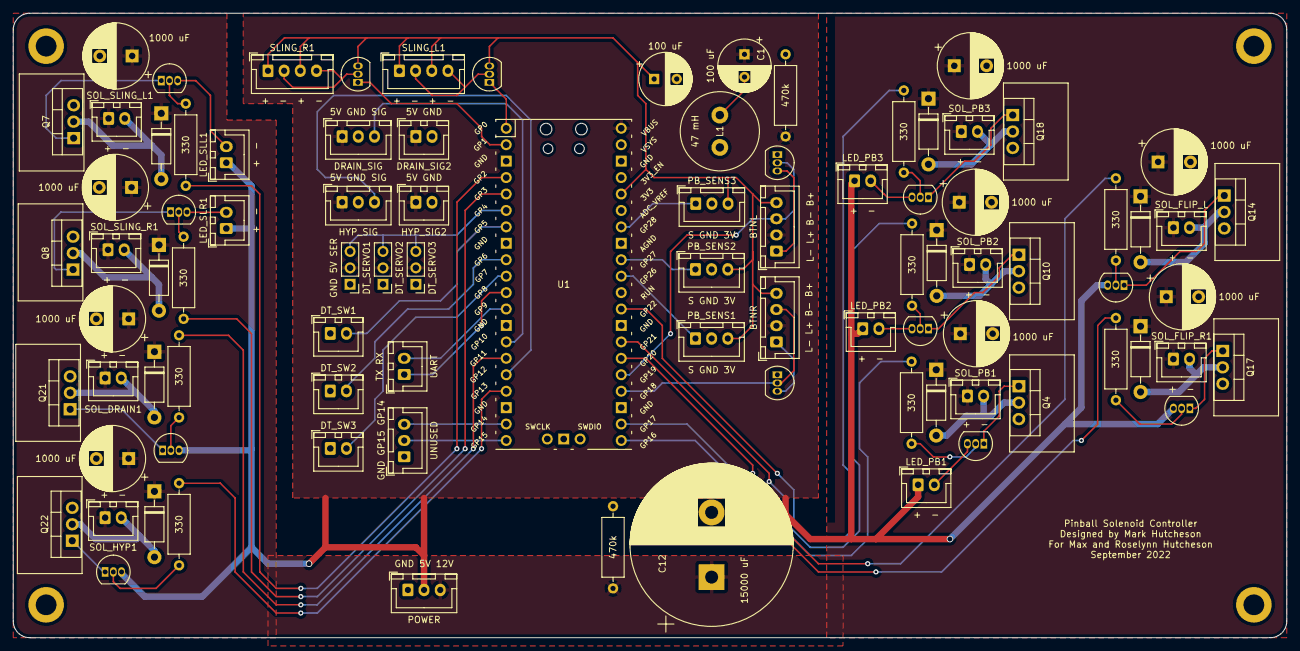
[picture p80: board PopBumperController.kicad_pcb from above]

Board: 2 copper layers, 196.8 x 96.5 mm, 90 parts (0 on the bottom side), 67 nets.

Other parts of the board:
BTNL: JST-XH x4; JST_XH_B4B-XH-A_1x04_P2.50mm_Vertical
BTNR: JST-XH x4; JST_XH_B4B-XH-A_1x04_P2.50mm_Vertical
SOL_FLIP_L: + -; JST_XH_B2B-XH-A_1x02_P2.50mm_Vertical

Their connections:
+3V3: BTNL.4, BTNR.4; also elsewhere on the board
+5V: BTNL.2, BTNR.2; also elsewhere on the board
+12V: SOL_FLIP_L.1; also elsewhere on the board
/TRIGGER_L: BTNL.3; also elsewhere on the board
/TRIGGER_R: BTNR.3; also elsewhere on the board
unnamed 28: BTNL.1; also elsewhere on the board
unnamed 29: BTNR.1; also elsewhere on the board
unnamed 34: SOL_FLIP_L.2; also elsewhere on the board
