meh2481/picopinball/KiCad/SoundController/SoundController/SoundController.kicad_pcb

## KiCad design KiCad/SoundController/SoundController/SoundController.kicad_pcb (2022-04-18)

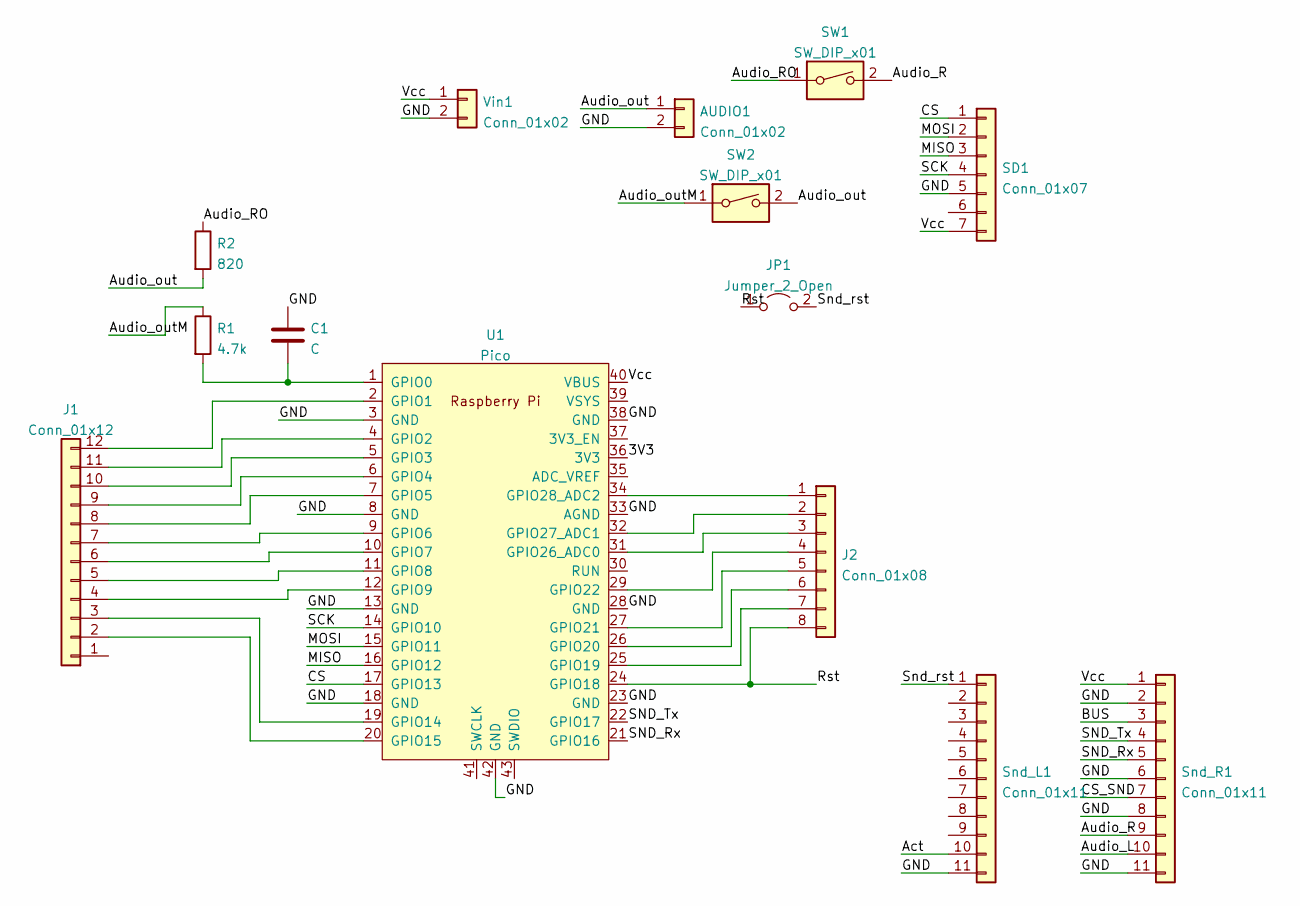
[picture p81: schematic SoundController.kicad_sch]

Parts:
AUDIO1: Conn_01x02; TerminalBlock_4Ucon_1x02_P3.50mm_Horizontal
C1: C; C_Disc_D7.5mm_W4.4mm_P5.00mm
J1: Conn_01x12; PinHeader_1x12_P2.54mm_Vertical
J2: Conn_01x08; PinHeader_1x08_P2.54mm_Vertical
JP1: Jumper_2_Open; PinHeader_1x02_P2.54mm_Vertical
R1: 4.7k; R_Axial_DIN0309_L9.0mm_D3.2mm_P15.24mm_Horizontal
R2: 820; R_Axial_DIN0309_L9.0mm_D3.2mm_P15.24mm_Horizontal
SD1: Conn_01x07; PinHeader_1x07_P2.54mm_Vertical
SW1, SW2: SW_DIP_x01; TerminalBlock_4Ucon_1x02_P3.50mm_Horizontal
Snd_L1: Conn_01x11; PinHeader_1x11_P2.54mm_Vertical
Snd_R1: Conn_01x11; PinHeader_1x11_P2.54mm_Vertical
U1: Pico; RPi_Pico_SMD_TH
Vin1: Conn_01x02; TerminalBlock_4Ucon_1x02_P3.50mm_Horizontal

Connections:
/3V3: U1.36 (3V3)
/Act: Snd_L1.10
/Audio_L: Snd_R1.10
/Audio_R: SW1.2, Snd_R1.9
/Audio_RO: R2.1, SW1.1
/Audio_out: AUDIO1.1, R2.2, SW2.2
/Audio_outM: R1.1, SW2.1
/BUS: Snd_R1.3
/CS: SD1.1, U1.17 (GPIO13)
/CS_SND: Snd_R1.7
/GND: AUDIO1.2, C1.1, SD1.5, Snd_L1.11, Snd_R1.2, Snd_R1.6, Snd_R1.8, Snd_R1.11, U1.3 (GND), U1.8 (GND), U1.13 (GND), U1.18 (GND), U1.23 (GND), U1.28 (GND), U1.33 (AGND), U1.38 (GND), U1.42 (GND), Vin1.2
/MISO: SD1.3, U1.16 (GPIO12)
/MOSI: SD1.2, U1.15 (GPIO11)
/Rst: J2.8, JP1.1 (A), U1.24 (GPIO18)
/SCK: SD1.4, U1.14 (GPIO10)
/SND_Rx: Snd_R1.5, U1.21 (GPIO16)
/SND_Tx: Snd_R1.4, U1.22 (GPIO17)
/Snd_rst: JP1.2 (B), Snd_L1.1
/Vcc: SD1.7, Snd_R1.1, U1.40 (VBUS), Vin1.1
unnamed: C1.2, R1.2, U1.1 (GPIO0)
unnamed: J1.2, U1.20 (GPIO15)
unnamed: J1.3, U1.19 (GPIO14)
unnamed: J1.4, U1.12 (GPIO9)
unnamed: J1.5, U1.11 (GPIO8)
unnamed: J1.6, U1.10 (GPIO7)
unnamed: J1.7, U1.9 (GPIO6)
unnamed: J1.8, U1.7 (GPIO5)
unnamed: J1.9, U1.6 (GPIO4)
unnamed: J1.10, U1.5 (GPIO3)
unnamed: J1.11, U1.4 (GPIO2)
unnamed: J1.12, U1.2 (GPIO1)
unnamed: J2.1, U1.34 (GPIO28_ADC2)
unnamed: J2.2, U1.32 (GPIO27_ADC1)
unnamed: J2.3, U1.31 (GPIO26_ADC0)
unnamed: J2.4, U1.29 (GPIO22)
unnamed: J2.5, U1.27 (GPIO21)
unnamed: J2.6, U1.26 (GPIO20)
unnamed: J2.7, U1.25 (GPIO19)

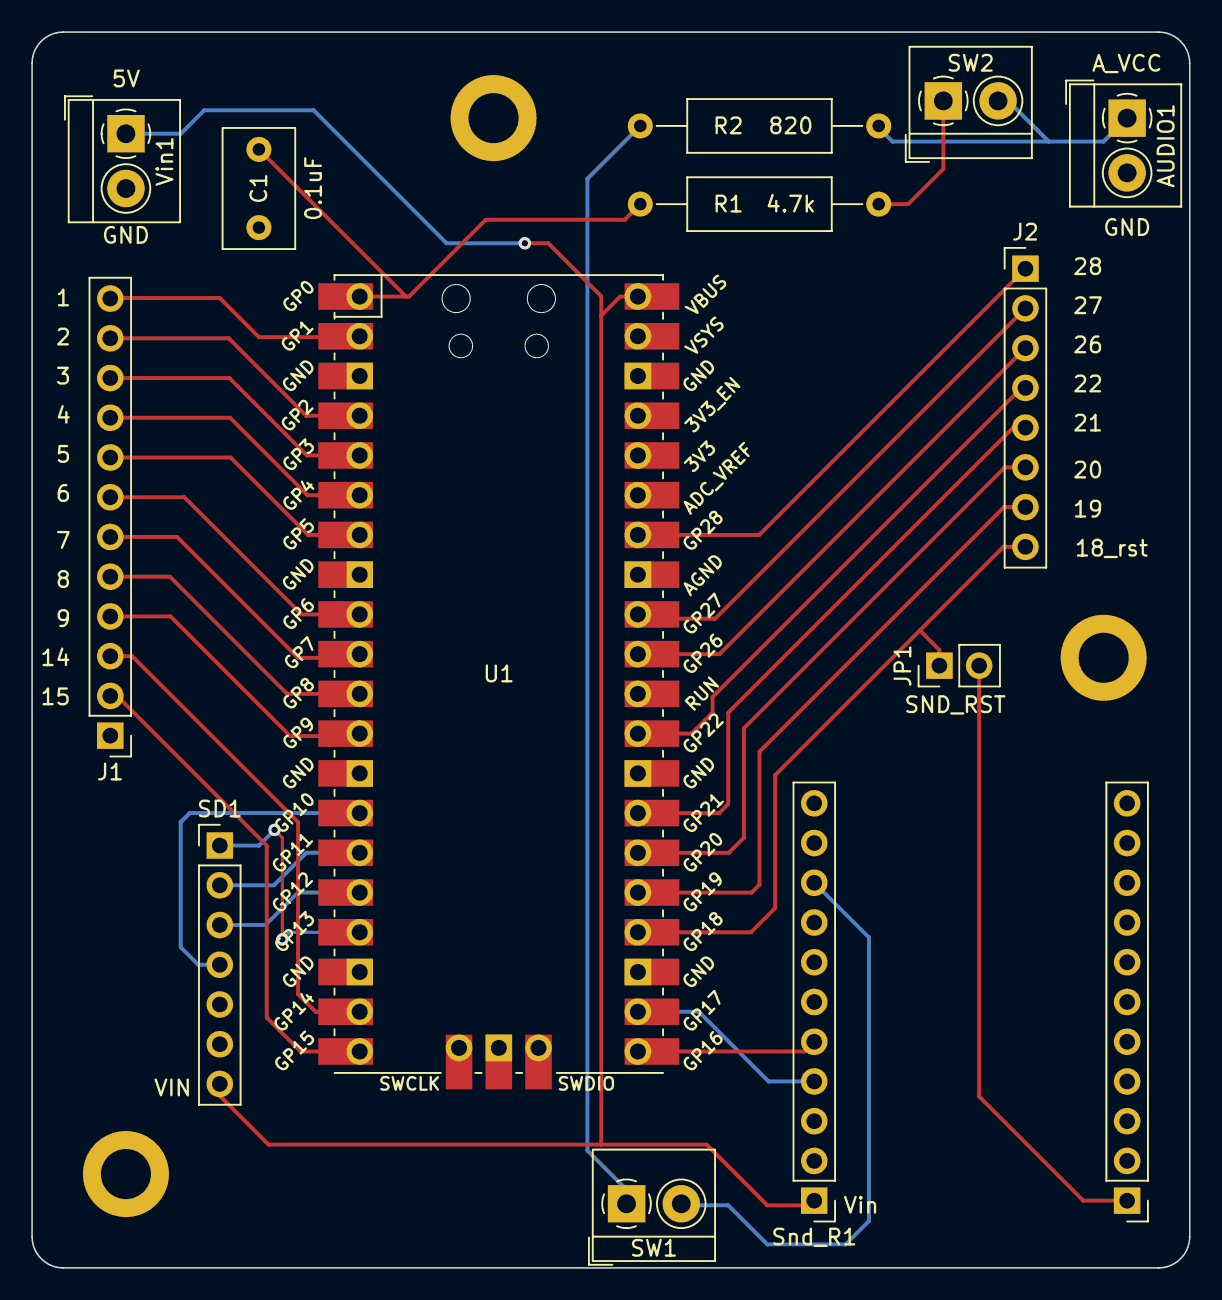
[picture p82: board SoundController.kicad_pcb from above]

Board: 2 copper layers, 74.0 x 79.0 mm, 14 parts (0 on the bottom side), 33 nets.
