meh2481/picopinball/KiCad/Pop Bumper/PopBumper/PopBumper.kicad_pcb

## KiCad design KiCad/Pop Bumper/PopBumper/PopBumper.kicad_pcb (2022-04-18)

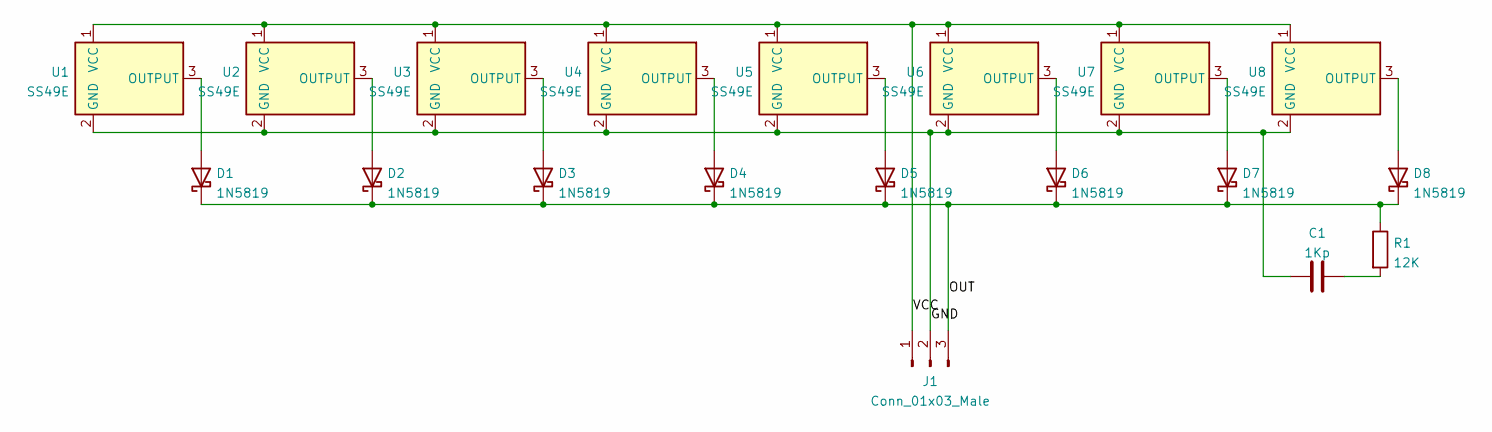
[picture p83: schematic PopBumper.kicad_sch]

Parts:
C1: 1Kp; C_Disc_D5.1mm_W3.2mm_P5.00mm
D1, D2, D3, D4, D5, D6, D7, D8: 1N5819; D_DO-41_SOD81_P10.16mm_Horizontal
J1: Conn_01x03_Male; PinHeader_1x03_P2.54mm_Vertical
R1: 12K; R_Axial_DIN0309_L9.0mm_D3.2mm_P2.54mm_Vertical
U1, U2, U3, U4, U5, U6, U7, U8: SS49E; PinHeader_1x03_P1.27mm_Vertical

Connections:
/GND: C1.1, J1.2, U1.2 (GND), U2.2 (GND), U3.2 (GND), U4.2 (GND), U5.2 (GND), U6.2 (GND), U7.2 (GND), U8.2 (GND)
/OUT: D1.1 (K), D2.1 (K), D3.1 (K), D4.1 (K), D5.1 (K), D6.1 (K), D7.1 (K), D8.1 (K), J1.3, R1.1
/VCC: J1.1, U1.1 (VCC), U2.1 (VCC), U3.1 (VCC), U4.1 (VCC), U5.1 (VCC), U6.1 (VCC), U7.1 (VCC), U8.1 (VCC)
unnamed: D1.2 (A), U1.3 (OUTPUT)
unnamed: D2.2 (A), U2.3 (OUTPUT)
unnamed: D4.2 (A), U4.3 (OUTPUT)
unnamed: D5.2 (A), U5.3 (OUTPUT)
unnamed: D6.2 (A), U6.3 (OUTPUT)
unnamed: D7.2 (A), U7.3 (OUTPUT)
unnamed: C1.2, R1.2
unnamed: D3.2 (A), U3.3 (OUTPUT)
unnamed: D8.2 (A), U8.3 (OUTPUT)

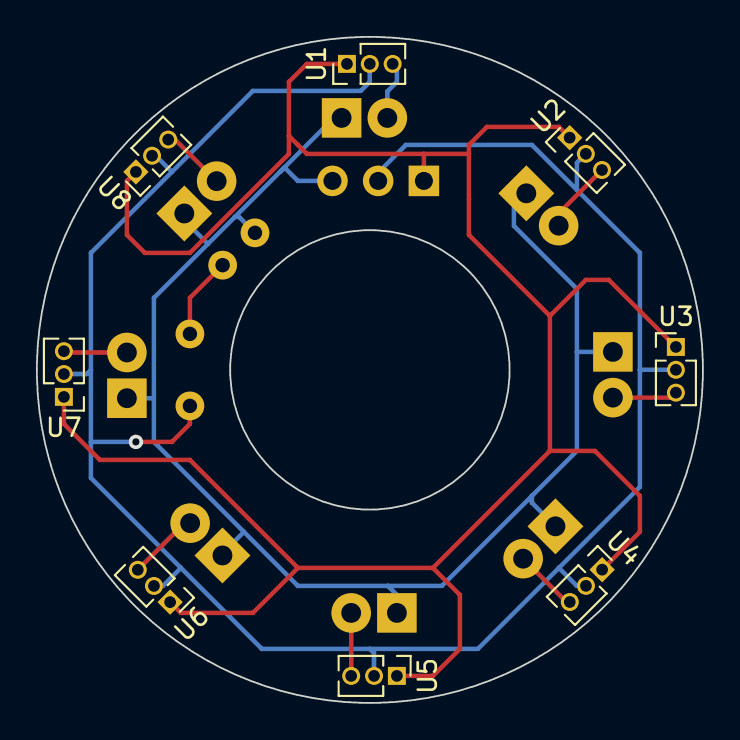
[picture p84: board PopBumper.kicad_pcb from above]

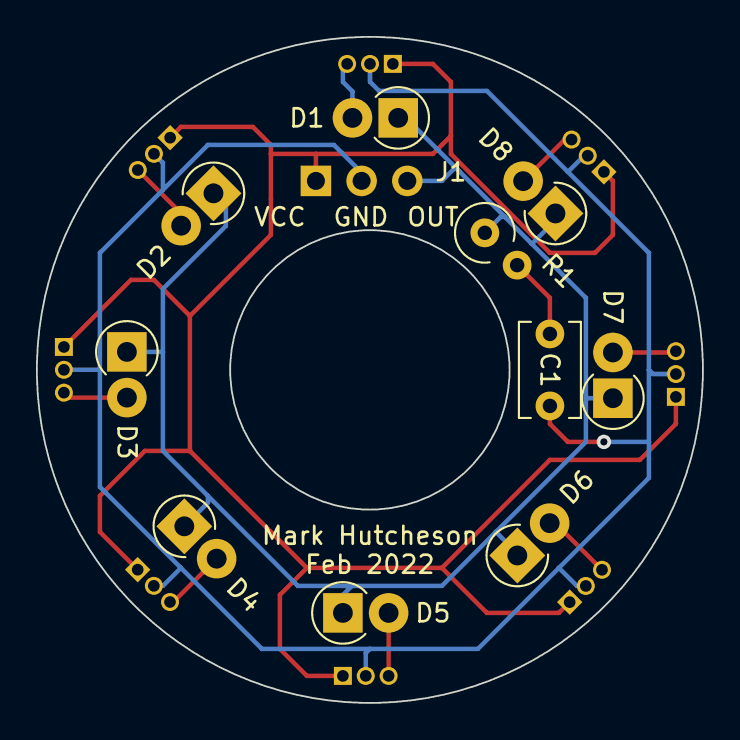
[picture p85: board PopBumper.kicad_pcb from below]

Board: 2 copper layers, 37.0 x 37.0 mm, 19 parts (11 on the bottom side), 12 nets.
