meh2481/picopinball/KiCad/ExpansionBoard/ExpansionBoard/ExpansionBoard.kicad_pcb

## KiCad design KiCad/ExpansionBoard/ExpansionBoard/ExpansionBoard.kicad_pcb (2022-04-18)

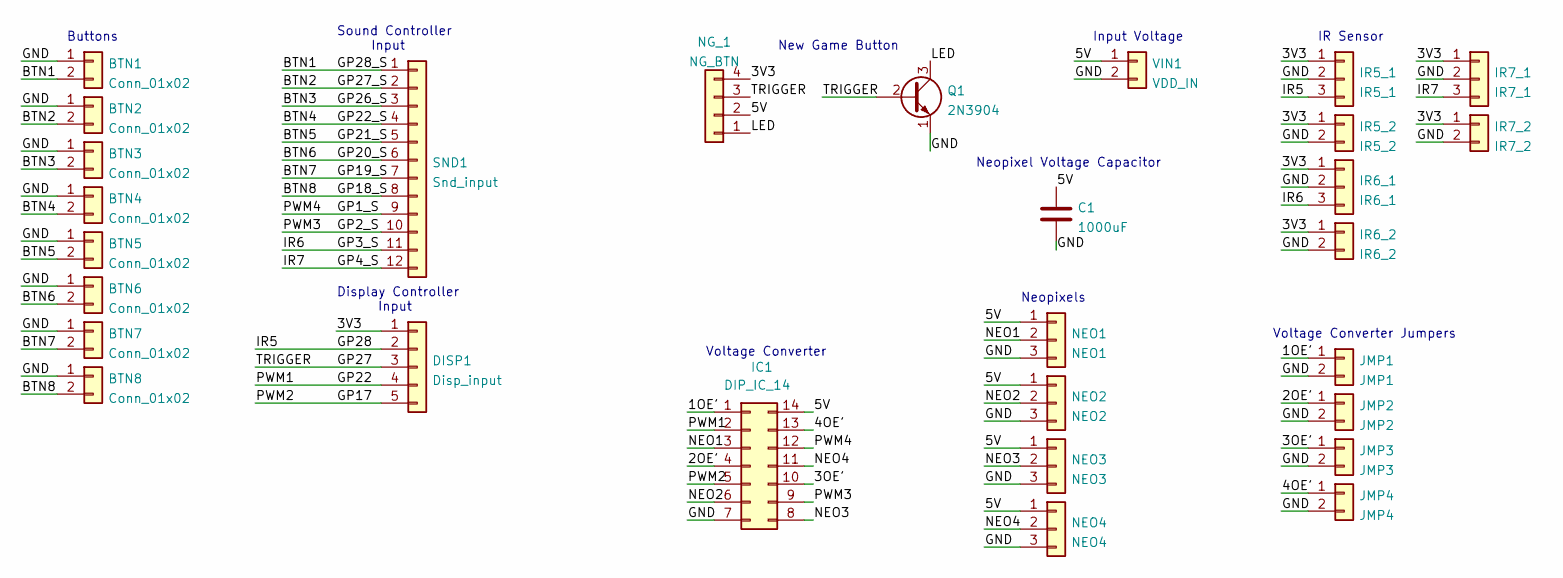
[picture p86: schematic ExpansionBoard.kicad_sch]

Parts:
BTN1, BTN2, BTN3, BTN4, BTN5, BTN6, BTN7, BTN8: Conn_01x02; JST_XH_B2B-XH-A_1x02_P2.50mm_Vertical
C1: 1000uF; CP_Radial_D10.0mm_P5.00mm
DISP1: Disp_input; JST_XH_B5B-XH-A_1x05_P2.50mm_Vertical
IC1: DIP_IC_14; DIP-14_W7.62mm_LongPads
IR5_1: IR5_1; JST_XH_B3B-XH-A_1x03_P2.50mm_Vertical
IR5_2: IR5_2; JST_XH_B2B-XH-A_1x02_P2.50mm_Vertical
IR6_1: IR6_1; JST_XH_B3B-XH-A_1x03_P2.50mm_Vertical
IR6_2: IR6_2; JST_XH_B2B-XH-A_1x02_P2.50mm_Vertical
IR7_1: IR7_1; JST_XH_B3B-XH-A_1x03_P2.50mm_Vertical
IR7_2: IR7_2; JST_XH_B2B-XH-A_1x02_P2.50mm_Vertical
JMP1: JMP1; PinHeader_1x02_P2.54mm_Vertical
JMP2: JMP2; PinHeader_1x02_P2.54mm_Vertical
JMP3: JMP3; PinHeader_1x02_P2.54mm_Vertical
JMP4: JMP4; PinHeader_1x02_P2.54mm_Vertical
NEO1: NEO1; JST_PH_B3B-PH-K_1x03_P2.00mm_Vertical
NEO2: NEO2; JST_PH_B3B-PH-K_1x03_P2.00mm_Vertical
NEO3: NEO3; JST_PH_B3B-PH-K_1x03_P2.00mm_Vertical
NEO4: NEO4; JST_PH_B3B-PH-K_1x03_P2.00mm_Vertical
NG_1: NG_BTN; JST_XH_B4B-XH-A_1x04_P2.50mm_Vertical
Q1: 2N3904; TO-92_Inline
SND1: Snd_input; TerminalBlock_Phoenix_MPT-0,5-12-2.54_1x12_P2.54mm_Horizont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
VIN1: VDD_IN; JST_XH_B2B-XH-A_1x02_P2.50mm_Vertical

Connections:
/1OE': IC1.1, JMP1.1
/2OE': IC1.4, JMP2.1
/3OE': IC1.10, JMP3.1
/3V3: DISP1.1, IR5_1.1, IR5_2.1, IR6_1.1, IR6_2.1, IR7_1.1, IR7_2.1, NG_1.4
/4OE': IC1.13, JMP4.1
/5V: C1.1, IC1.14, NEO1.1, NEO2.1, NEO3.1, NEO4.1, NG_1.2, VIN1.1
/BTN1: BTN1.2, SND1.1
/BTN2: BTN2.2, SND1.2
/BTN3: BTN3.2, SND1.3
/BTN4: BTN4.2, SND1.4
/BTN5: BTN5.2, SND1.5
/BTN6: BTN6.2, SND1.6
/BTN7: BTN7.2, SND1.7
/BTN8: BTN8.2, SND1.8
/GND: BTN1.1, BTN2.1, BTN3.1, BTN4.1, BTN5.1, BTN6.1, BTN7.1, BTN8.1, C1.2, IC1.7, IR5_1.2, IR5_2.2, IR6_1.2, IR6_2.2, IR7_1.2, IR7_2.2, JMP1.2, JMP2.2, JMP3.2, JMP4.2, NEO1.3, NEO2.3, NEO3.3, NEO4.3, Q1.1 (E), VIN1.2
/GP3_S: IR6_1.3, SND1.11
/GP4_S: IR7_1.3, SND1.12
/IR5: DISP1.2, IR5_1.3
/LED: NG_1.1, Q1.3 (C)
/NEO1: IC1.3, NEO1.2
/NEO2: IC1.6, NEO2.2
/NEO3: IC1.8, NEO3.2
/NEO4: IC1.11, NEO4.2
/PWM1: DISP1.4, IC1.2
/PWM2: DISP1.5, IC1.5
/PWM3: IC1.9, SND1.10
/PWM4: IC1.12, SND1.9
/TRIGGER: DISP1.3, NG_1.3, Q1.2 (B)

Notes on the sheet:
Voltage Converter
Buttons
IR Sensor
Display Controller Input
Input Voltage
Neopixel Voltage Capacitor
Neopixels
Sound Controller Input
New Game Button
Voltage Converter Jumpers

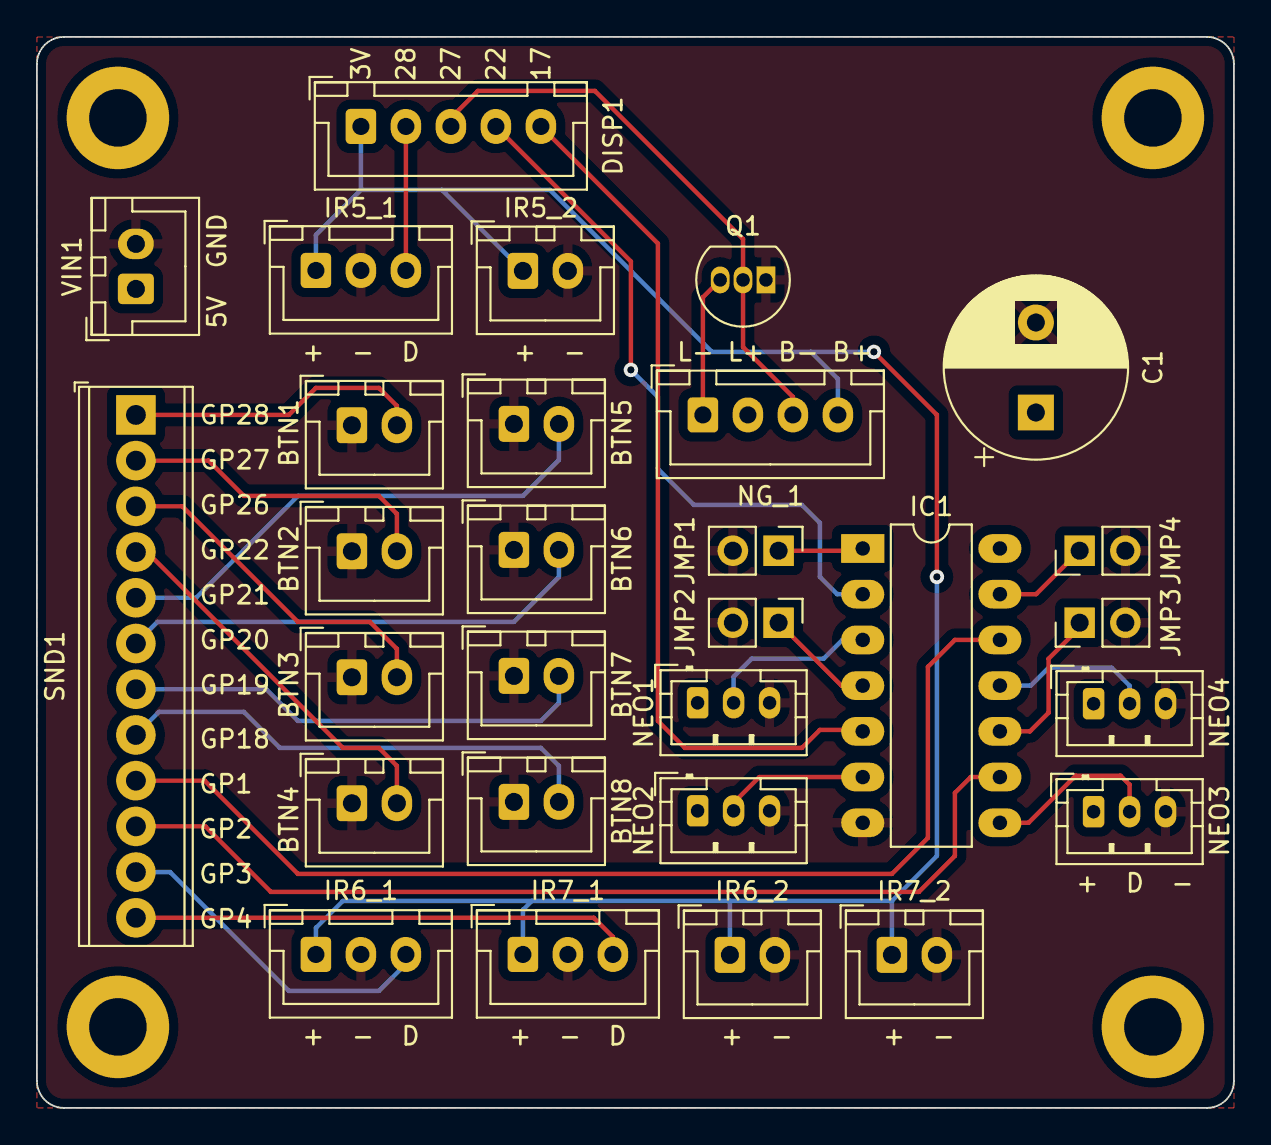
[picture p87: board ExpansionBoard.kicad_pcb from above]

Board: 2 copper layers, 66.5 x 59.5 mm, 29 parts (0 on the bottom side), 28 nets.
