meh2481/picopinball/KiCad/VoltageDistributor/VoltageDistributor/VoltageDistributor.kicad_pcb

## KiCad design KiCad/VoltageDistributor/VoltageDistributor/VoltageDistributor.kicad_pcb (2022-04-18)

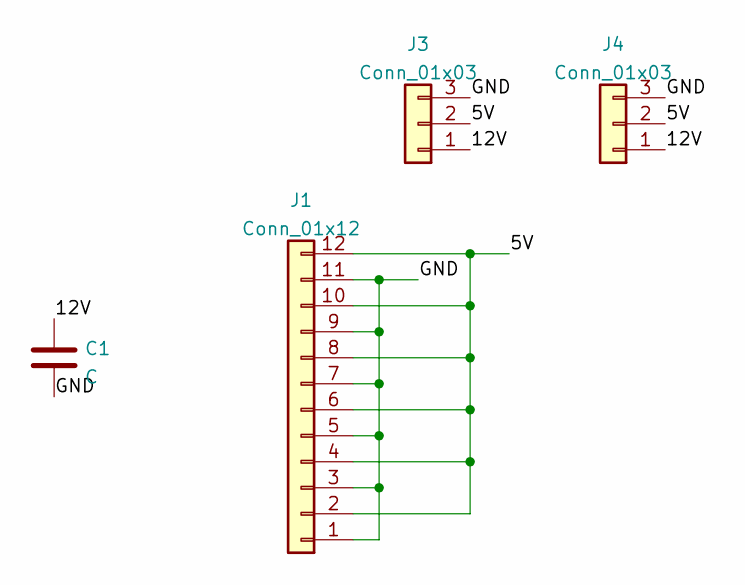
[picture p88: schematic VoltageDistributor.kicad_sch]

Parts:
C1: C; CP_Radial_D25.0mm_P10.00mm_SnapIn
J1: Conn_01x12; TerminalBlock_Phoenix_MPT-0,5-12-2.54_1x12_P2.54mm_Horizont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
J3, J4: Conn_01x03; JST_XH_B3B-XH-A_1x03_P2.50mm_Vertical

Connections:
/5V: J1.2, J1.4, J1.6, J1.8, J1.10, J1.12, J3.2, J4.2
/12V: C1.1, J3.1, J4.1
/GND: C1.2, J1.1, J1.3, J1.5, J1.7, J1.9, J1.11, J3.3, J4.3

Board: 2 copper layers, 4 parts (0 on the bottom side), 3 nets, no tracks yet.
