meh2481/picopinball/(commit log)

2022-04-04 add current code for soundController & scoreController
2022-04-06 Turn on LED by default, cycle through hyperspace test sounds
2022-04-16 Add initial solenoid driver test code
2022-04-16 pop bumper code but it doesn't work this time
    [code.py]
2022-04-16 fix software bugs (and hardware ones aaaa)
    [code.py]
2022-04-18 Add kicad files
    [ExpansionBoard.kicad_pcb, ExpansionBoard.kicad_sch, PopBumper.kicad_pcb, PopBumper.kicad_sch, PopBumperController.kicad_pcb, PopBumperController.kicad_sch, ScoreController.kicad_pcb, ScoreController.kicad_sch]
2022-04-18 Add FreeCad files
    [centralLights.FCStd, dropTarget.FCStd, dropTarget_Target.FCStd, flipper.FCStd, flipper2.FCStd, flipperSpringMockup.FCStd, flipper_underside.FCStd, flipper_underside2.FCStd]
2022-05-08 Add button array and bracket
    [boardLayout.FCStd, button.FCStd, buttonSwitch_bracket.FCStd]
2022-05-19 Moar board layout
    [boardLayout.FCStd]
2022-05-24 Working on board layout
    [pinballBumperSm.FCStd]
2022-05-24 layout drop targets
    [dropTarget.FCStd, dropTarget_Target.FCStd, pinballBumper.FCStd, pinballBumperSm.FCStd]
2022-05-26 Continue board layout
2022-05-29 Moar hyperspace layout
    [solenoidMockup.FCStd]
2022-05-30 Moar colors, moar board
2022-05-30 Better solenoid mockup
    [solenoidMockup.FCStd]
2022-06-23 Disable drop targets for testing because timing bugs, fix a few cad things.
    [flipper_underside.FCStd, flipper_underside2.FCStd, flipper_underside3.FCStd, flipper_underside4.FCStd, flipper_underside5.FCStd, slingshot2.FCStd, slingshot_switch5.FCStd]
2022-08-31 Update some CAD files, redesign solenoid controller circuit
    [PopBumperController.kicad_sch, dropTarget.FCStd, flipperBearingHolder.FCStd, flipper_underside5.FCStd, popBumperTestBoard2.FCStd, slingshot_switch5.FCStd, switchHolder.FCStd]
2022-09-01 Fix schematic issues, start PCB layout
    [PopBumperController.kicad_pcb, PopBumperController.kicad_sch]
2022-09-02 yay dun wiren
    [PopBumperController.kicad_pcb]
2022-09-14 Bracket assembly updates, new solenoid controller pcb design, new driver to potentially use a different display
    [PopBumperController.kicad_pcb, dropTarget.FCStd, popBumperAssembly.FCStd, popBumperTestBoard2.FCStd]
2022-09-25 Update some freecad models
    [popBumperTestBoard2.FCStd, switchBracket2.FCStd, switchHolder.FCStd]
2022-09-28 Add drawings to freecad board layout, delete doc as it was getting too large
2022-09-30 Add amplifier bracket, cable clip, speaker hole jig
    [amplifierBracket.FCStd, cableClip.FCStd, speakerHoleJig.FCStd]
2022-10-09 Add plexiglass strips, spaceship post cover
    [ledStripTrack.FCStd, ledStripTrack_noCorners.FCStd, ledStripTrack_noCorners_extended.FCStd, plexiglassGuide.FCStd, spaceship_postHolder_part2.FCStd, spaceship_post_cover.FCStd]
2022-10-10 Add plexiglass corner brackets
    [cornerPlexiglassBracket.FCStd, ledStripTrack_noCorners_extended.FCStd]
2022-10-10 Add box measurements
    [boxMeasurements.FCStd]
2022-10-22 Actually coding wat
    [cableClip-taller.FCStd, slingshot2.FCStd, slingshotCover.FCStd]
2022-10-25 Startup sound, IR sensors for sound controller r now
    [dowelSpringPlug.FCStd, pegglePeg.FCStd]
2022-10-25 Setup top IR sensors as interrupts
2022-10-25 Board illumination, add mission select button detection
2022-10-29 Filling out some inter-board communication
2022-10-29 Remember to relay point updates to sound controller
2022-10-29 Mark some things that need fixing
    [code.py]
2022-10-30 Clearly mark bugs that are causing issues rn
    [code.py]
2022-10-30 Fix some solenoid point timings, red for slightly longer on ball drain
    [code.py]
2022-10-31 Add LED test for the rest of the LEDs on the i2c expander and both other i2c expanders
2022-11-01 Startup delay for solenoid driver because display controller is actually that slow
2022-11-01 some fixes, range checking
    [code.py]
2022-11-01 Something broke in the previous 2 commits beforore this one
    [ScoreController.kicad_pcb]
2022-11-02 Move UART initialization first
2022-11-02 Don't spam the UART bus every frame, freezing everything
2022-11-03 idk what I did but I think I fixed it now
    [code.py]
2022-11-03 Remove startup anim, swap UART initialization back to the end instead of the start
    [code.py]
2022-11-03 Fix off-by-one ball counting error, cancel reload animation on gameover
    [code.py]
2022-11-03 Fix some gameover anim bugs
    [code.py]
2022-11-03 Turn drop targets back on when resetting, not before (fixes visual bug with one light staying off)
    [code.py]
2022-11-05 Add sd copy util program, swap over to wav music
    [code.py]
2022-11-08 Add blinky to center pixel, fix some bugs with anim
    [code.py]
2022-11-09 Add tiny cable clip, ball deploy light code, fix anim bugs untested
    [cableClip_tiny.FCStd]
2022-11-10 Fix hyperspace launch sound on mission complete
    [code.py]
2022-11-10 Fix chase animation and add it
    [code.py]
2022-11-10 Wav for smoother LED animations
2022-11-12 Fix bug with selecting mission with active mission already untested
    [code.py]
2022-11-14 Add PWM to flipper solenoids
    [code.py]
2022-11-15 Fix one bug in status text
    [code.py]
2022-11-15 Fix some bugs with message display logic
    [code.py]
2022-11-15 Squelch one more message display bug
    [code.py]
2022-11-16 Bracket for display
    [displayBracket.FCStd]
2022-11-17 Add light blinking support untested
    [displayBracket.FCStd, ledRingHolder.FCStd]
2022-11-17 Fix bugs with blink anims
    [code.py]
2022-11-18 remove duplicate dt light reset untested
    [code.py]
2022-11-19 Add circular light holder
    [circleLightHolder-old.FCStd, circleLightHolder.FCStd]
2022-11-23 More better measurements, hyperspace bar lights
    [circleLightHolder.FCStd, hyperspaceBarLight-36.FCStd, hyperspaceBarLight.FCStd, slingshotCover.FCStd, threeArrowsLightHolder.FCStd, triangleLightHolder.FCStd]
2022-11-24 gameover stops flipper control untested
    [code.py]
2022-11-26 Add some initial new light anim tests
    [slingshot_switch4.FCStd]
2022-11-27 Squash a bunch of bugs
    [code.py]
2022-11-27 Fix bug in redeploy when blink animation is currently going upon drain
    [code.py]
2022-11-28 Add re-entry light cycle with flippers, squash some boogs
    [code.py]
2022-11-28 Fix bug in ir lights not being cleared between games
    [code.py]
2022-11-28 Fix hyperspace light blinking bug if hyperspace when anim incomplete, add TODO items
    [code.py]
2022-11-28 Add animation for accepting mission, fix swallowed extra ball on mission accept
    [code.py]
2022-11-29 Blink lights at the same time, swap hyperspace and bumper missions
    [code.py]
2022-11-29 Fix bug with mission select anim on re-entry after redeploy/extra ball
    [code.py]
2022-11-29 Flipper size tweaking
    [flipper2.FCStd]
2022-11-29 Working on fixing a bug with center ring state, different sound when drain if replay/redeploy
    [code.py]
2022-11-29 The best part is no part
    [pinballBumper.FCStd]
2022-12-01 Add plunger guide thingy, increase solenoid driver sensitivity and make it configurable
    [plungerGuide.FCStd]
2022-12-03 Time-delay ring reset to overwrite a weird graphical neopixel glitch
    [code.py]
